yangwei251003/phyllotaxis/mechanical/BRIEF.md

# 参数化结构简报 · 历史设计过程

当前使用 [PROTO-02结构说明](prototype-v02/BRIEF.md)。下文保留旧电容高度等历史推导；最新总装为 `prototype-v02/assembly.step`。支持器件生成器默认使用PROTO-02，只有显式设置空版本变量才重放v01。

桌面光盘，水平放置；单位 mm，XY 为灯板平面，Z 向上，原点在底壳底面中心。尺寸见唯一来源 `../shared/design.json`。

设计由底壳、前框、2 mm 亚克力扩散片、PCB 包络和144个灯珠包络组成。外径200、底壳高42、壁厚3、底板厚3；180 mm PCB 底面安装高度30；四个M3通孔在85 mm半径上，与PCB共用坐标。

底壳预留通风槽、带护线圈的低压电源线入口和通用扎带固定孔。主控采用WeAct官方V3.1参考STEP；实际采购板与排针仍未核验。SEN0526麦克风支架及侧控件见下文controls-candidate-01。采购件3D模型技能在当前安装目录未找到，LED暂用供应商标称5×5×1.57包络，PCB为本设计外形包络。

前框以M3塑料自攻或经实测确认的螺钉装配；螺钉长度、孔收缩量、线缆护圈和模块固定点需最终器件实物核对。外壳不是已经验证的生产件。FDM初始建议PETG、0.2mm层高、4圈壁、20%填充；实际工艺由制造商确认。

DfAM修订：旧前框网格采样最薄0.505mm、p05=1mm，小于技能默认FDM支撑壁1.2mm，不能作为打印定稿。前框厚度由3改4mm，扩散片座底厚由1改2mm，前框螺钉中心半径由94改96mm，底壳对应柱半径由5改3.9mm以保持200mm外径。名义孔边到凹槽和外圆均留2.3mm；前框当前几何与concept-02一致。

器件净空修订：470uF候选电容数据表给出L=7.7mm、a=0.5mm，即以8.2mm作为最大总高包络。旧PCB顶面至扩散片仅8.4mm，剩0.2mm不够装配。因此底壳高由38改42mm，总装高46mm；PCB安装高度不变，正面空腔增为12.4mm，电容包络净空4.2mm。另计0.8mm装配/翘曲设计余量后仍余3.4mm，高于本项目自行设定的2mm目标。0.8mm不是厂家公差承诺。2026-10-03已将电容及其余支持器件实体摆放并检查，结果见12号文档，仍须实物验证。

THT接插件已置于PCB背面空腔，候选装配服务必须包含反面插件安装；当前位置和假定配插/线缆包络见08号文档，已做18组实体干涉检查。实际线材、插拔和焊脚尺寸仍须核验。

验收：每个主件为正体积闭合实体；外径和总高满足参数；孔与PCB同轴；LED与安装孔无碰撞；PCB与扩散片有正间隙；导出STEP/STL、实测渲染。量产公差、散热、电气安全和实际装配未验证。

## 可拆主控托架 · holder-candidate-01

这是新增零件与装配，不更改灯阵或外壳外径。托架原点位于自身底面中心，全局安装在底壳地板Z=3mm；PCB下表面座在全局Z=22mm，板的XY中心与底壳同心。WeAct原STEP原点在板角，上板面约Z=0、下板面约Z=-1.49144；通过命名座面与板中心下表面刚性配合，禁止目测拖动对齐。

托盘66×46mm、底厚3mm；长边两侧承托板外缘各0.6mm，不压住排针孔列。两根独立压条厚2.4mm，板厚设计包络1.8mm并另留0.3mm高度余量，限制抬起而不施加夹紧力。四个M3孔与2.6mm试验导孔同轴；导孔/螺钉需试配，尚未验证螺纹强度。两条尼龙扎带利用底壳既有孔，把托盘固定到底壳；底部脚垫需高于扎带厚度。

USB和SWD短边全开，板上三个键上方不设横梁。两侧排针下方各留51×3.6×15mm的假定线束空间，透明包络不是实物排针/插头模型，不能据此发布接线件采购规格。候选假设排针朝下、按本方案实际测试插线与弯曲半径。USB插拔留25×13×7mm服务空间；服务须移开灯板并断开外部5V，避免USB VBUS与外部供电并联。

路径：carrier.step.py、retainer.step.py（打印两件）、controller-assembly.step.py（官方板和托架）、controller-space.step.py（含假定空间）、service-assembly.step.py（拆灯板检查视图），均输出STEP。新打印件附STL/3MF。检验单实体、闭合正体积、包络、托架/板/压条相交体积、底壳接触、灯板净空、孔轴与扎带孔对齐、线束预留净距；生成并审查等轴与顶视图。实际板厚、针高、母头和线弯曲、打印收缩、固定强度未验证，不放行打印。

## 支持器件完整空间检查 · 2026-10-03

在保持灯阵、PCB、底壳和前框尺寸不变的前提下，把17个已布局SMD支持器件加入参数化装配。以当前原生PCB读回的器件位置/角度作为唯一位置来源；KiCad平面坐标(x,y)转换为机械坐标(x−100,100−y)，顶面器件使用同一逆时针旋转角。安装基面为PCB上表面Z=31.6mm，不根据预览手工拖动。

先检索step-parts：同routeId未找到可用匹配。已保存的LCSC库包含3D名称/UUID但不含STEP实体；针对电容和Q1的公开旧版STEP下载端点实测404。因此采用带来源和余量的封装包络，而不冒充厂商精确3D。每个包络由真实库器件body描线、原生焊盘外形和原厂最大外形矩形的凸包组成，再预留0.25mm平面余量；高度分别来自已核对图纸或明确工程预留。包络覆盖焊端、安装偏移的候选空间，不作为焊盘/电气模型。

主要新增输出为component-space.step.py/STEP，以及更新的assembly.step.py/STEP/GLB。17个包络分别验证闭合、正体积和安装基面；与底壳、前框、亚克力片、邻近LED、其他支持器件及背面连接器进行实体相交/最近距离核对。顶部还保留0.8mm装配/翘曲余量，净空目标2mm。最终板厚、元件公差及实际焊接仍需实物验证。原WeAct厂商STEP中已知的34项参考几何问题保留并单独报告；不能宣称总装所有厂商参考面已修复。

## 麦克风、按键和底脚 · controls-candidate-01

局部坐标X朝径向外、Y沿切线、Z向上。SEN0526支架在20°方位，板正面X=94、背面X=93、中心Z=18.5；2个Ø2安装孔位于Y=±6、Z=22。按二维孔位创建独立保守板及增大器件空间，不使用有缺陷的厂商模型作无碰撞证明。支架以底面Z=3落在壳地板，用2个M3通孔固定；上部两孔使用M1.6螺钉/螺母空间、2.2打印通孔与3.5AF螺母窝，避免要求打印1.3mm试验螺纹孔。针排在板背面朝壳内，支架下部留通道；需要商家按此方向预焊，具体接头/线弯尚未核验。侧壁Ø8声孔中心Z=19，用宽于参考声口偏移的开口避免按截图小孔坐标锁死声道；最终声学响应仍须测量。

两个GQ12H-10M-N按键位于160°/200°，中心Z=19。曲壁各融合22×22mm平面安装区，径向厚5mm（X95到100），通孔Ø12.4为候选打印余量；原厂图名义Ø12，收缩与最终装配须试配。头径13.9、突出2.9、后端19.5来自官方系列图；螺母Ø17×3及尾部12×9×9空间另标工程预留。拆下灯板后安装螺母、检查接线，不假定闭壳还能伸入扳手。

新增4个Ø12×5高的粘贴底脚空间，中心半径70，令M3底部头部与扎带离桌面。壳体本身仍高46mm，含未压缩底脚理论总高51mm；实际脚压缩和材料未核验。更新底壳、麦克风支架、控制装配/检修视图和总装STEP，打印件STL/3MF及DfAM检查；保留灯阵PCB和扩散片/前框不变。检查实体验证、孔轴/螺母窝关系、接触与穿透体积、声路及线束空间、基座连续性和新快照。
