yangwei251003/phyllotaxis/mechanical/prototype-v02/BRIEF.md

# PROTO-02 结构交付

单位mm；桌面水平摆放；外径200，总装高46，含5mm脚垫为51。完整STEP已重新读入，包络200×200×51，323个实体句柄；其中包含采购件参考模型，不是323个需要打印的零件。

本版只把灯板支持器件更新为八颗270µF电容。LED与板孔、连接器、壳体、前框、主控托架和麦克风支架没有变化。电容实体按6.1mm最大物理高度加0.4mm设计预留；21个支持器件空间检查无受测穿透，顶部净空5.9mm，扣0.8mm工程预留后5.1mm。

打印底壳base×1、前框bezel×1、主控托架carrier×1、压条retainer×2、麦克风支架microphone-holder×1，使用上层目录相应STL/3MF。材料PETG，参考切片208.82g；制造方须按实际设备重新切片并清除支撑，不使用另一台打印机的G-code。扩散片为Ø183.4×2mm亚克力，见`../diffuser.step`，另购四只Ø12×5mm脚垫。

采购件与紧固件、装配顺序见`../../docs/23-purchase-and-assembly.md`，电气连接与烧录见22号说明。主控需朝下排针版本，线束沿底部固定；拆灯板后才能维护USB和SWD端口。

`assembly.step.py`是最新入口。生成依赖本机CAD技能的cadgen与build123d、同目录高度/空间JSON、上层parts/controller/controls/connectors/components模块、shared数据及原厂参考STEP。现有独立STEP可直接在通用CAD软件打开，不依赖Python。

WeAct原厂参考模型有34项已记录几何问题，总装不称为全实体严格验证通过。打印件、孔配合、排针与线弯、负载与温升仍须实际安装验证；零件来源和未验证状态保留在资料中。
