yangwei251003/phyllotaxis/hardware/prototype-v02/PHYLLO-v02-schematic.pdf

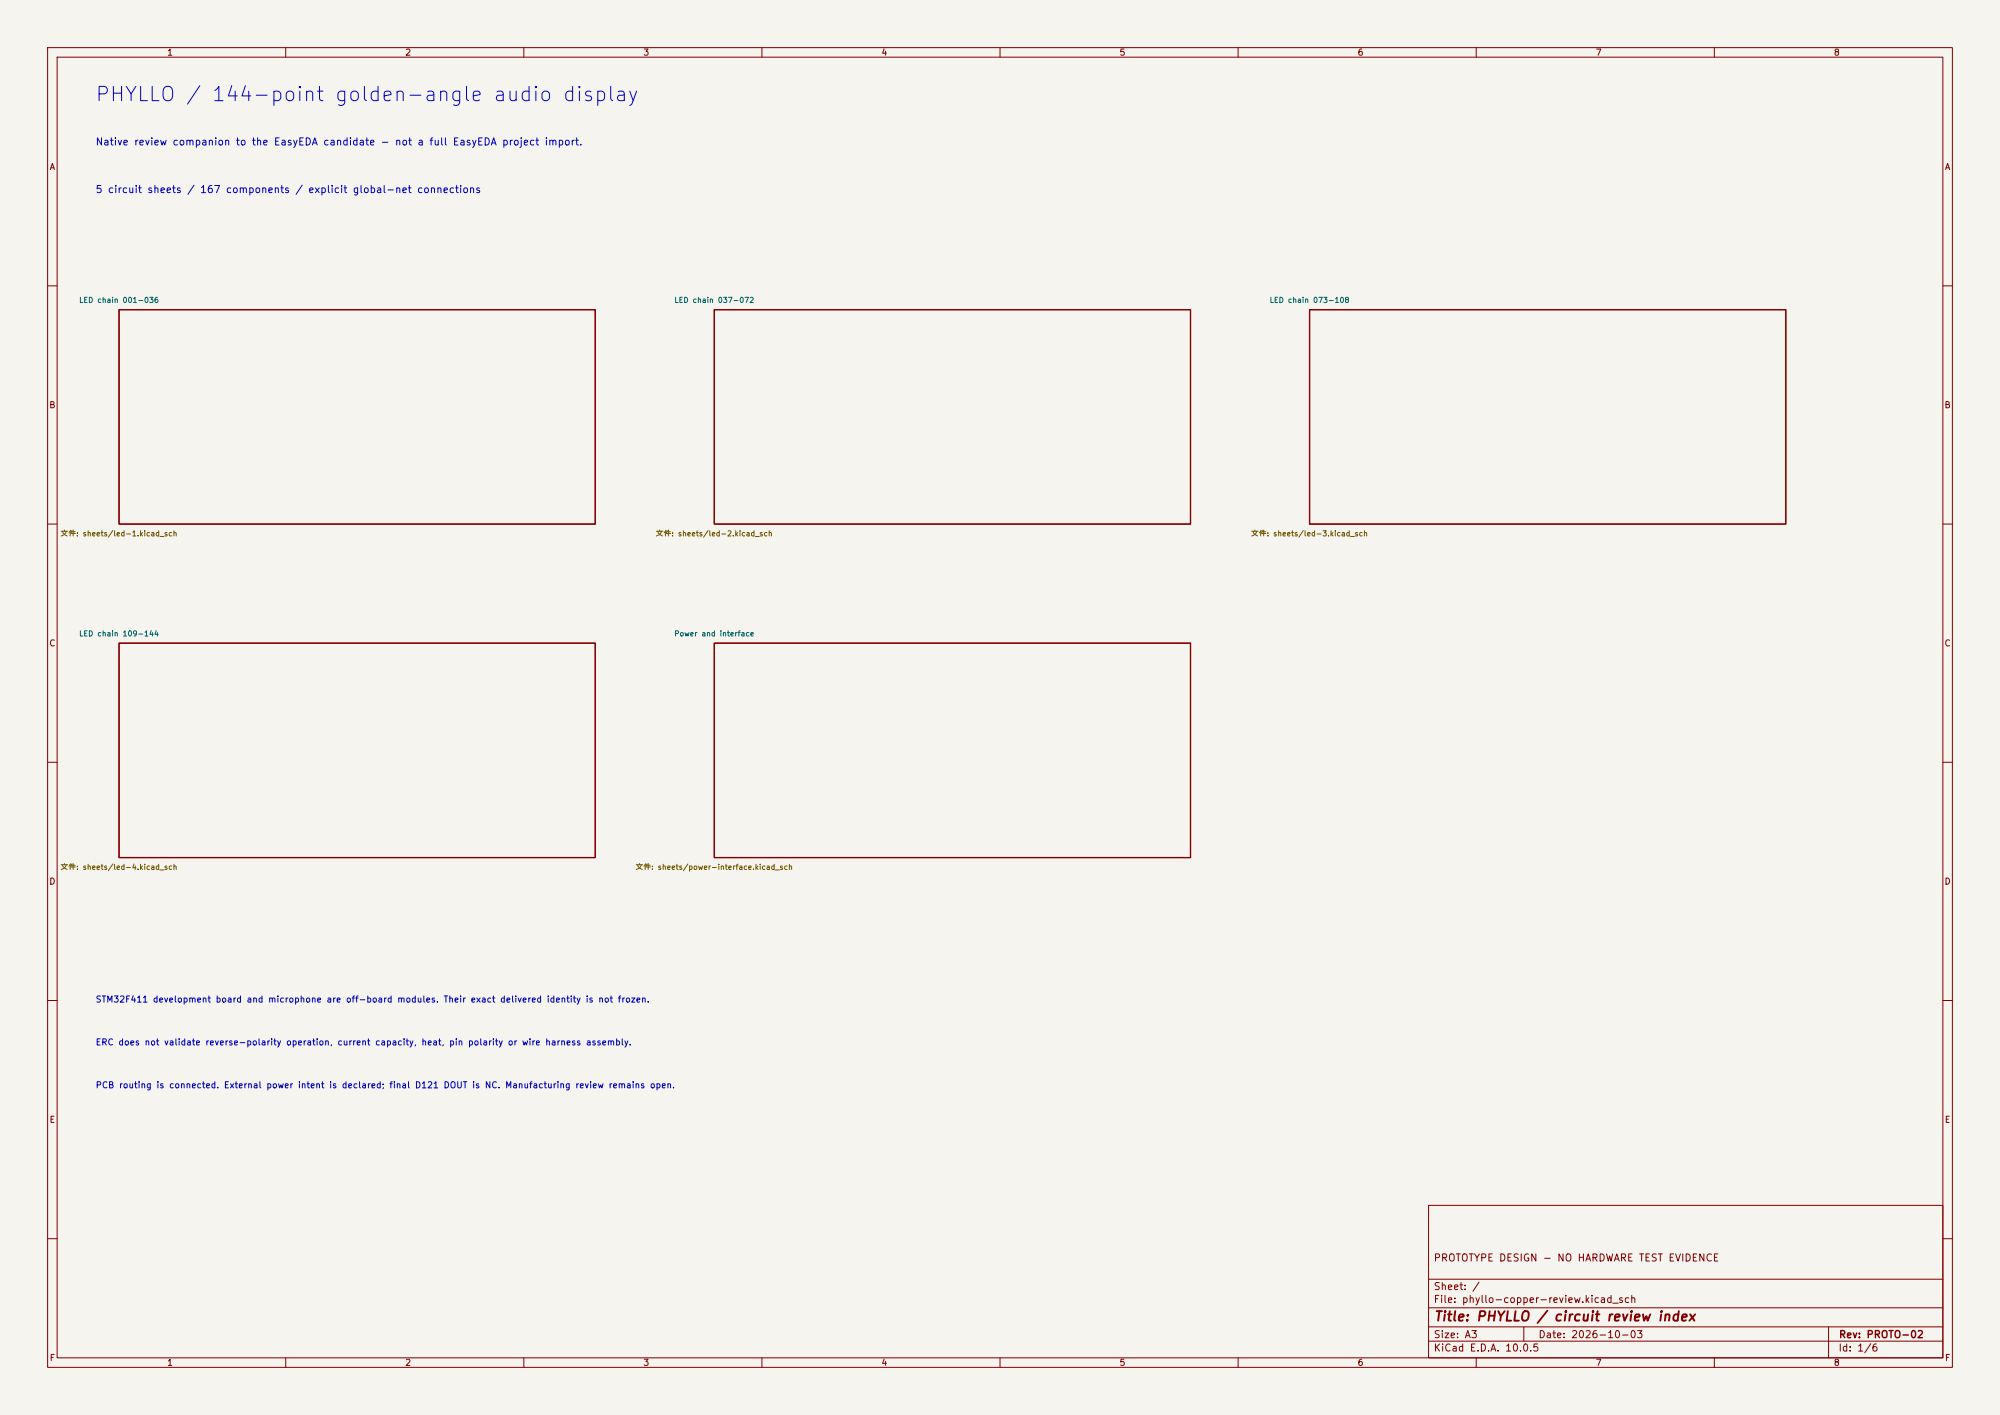
[picture p3: page 1]

STM32F411 development board and microphone are off-board modules. Their exact delivered identity is not frozen. ERC does not validate reverse-polarity operation, current capacity, heat, pin polarity or wire harness assembly. PCB routing is connected. External power intent is declared; final D121 DOUT is NC. Manufacturing review remains open. PHYLLO / 144-point golden-angle audio display
LED chain 001-036 文件: sheets/led-1.kicad_sch

Native review companion to the EasyEDA candidate - not a full EasyEDA project import.

5 circuit sheets / 167 components / explicit global-net connections

LED chain 073-108 文件: sheets/led-3.kicad_sch Power and interface 文件: sheets/power-interface.kicad_sch

LED chain 037-072 文件: sheets/led-2.kicad_sch

LED chain 109-144 文件: sheets/led-4.kicad_sch

PROTOTYPE DESIGN - NO HARDWARE TEST EVIDENCE

Sheet: /
File: phyllo-copper-review.kicad_sch
Title: PHYLLO / circuit review index

Size: A3 | Rev: PROTO-02 | F Date: 2026-10-03
KiCad E.D.A. 10.0.5 | Id: 1/6

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
# Title: LED chain 001-036

## File: led-1.kicad_sch

## Sheet: /LED chain 001-036/

## PROTOTYPE DESIGN - NO HARDWARE TEST EVIDENCE

VDD 1 | DOUT | 2
VSS | 3 DIN 4 | D94 WS2812B-B-V6
VDD 1 | DOUT | 2
VSS | 3 DIN 4 | D118 WS2812B-B-V6
VDD 1 | DOUT | 2
VSS | 3 DIN 4 | D89 WS2812B-B-V6
VDD 1 | DOUT | 2
VSS | 3 DIN 4 | D31 WS2812B-B-V6

VDD

1 | DOUT | 2
| VSS

3 DIN

4 | D144 WS2812B-B-V6
VDD 1 | DOUT | 2
VSS | 3 DIN 4 | D73 WS2812B-B-V6
VDD 1 | DOUT | 2
VSS | 3 DIN 4 | D126 WS2812B-B-V6
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

GND

DATA_109

5V_LED

5V_LED

DATA_114 | DATA_115 GND

DATA_115

5V_LED

GND

DATA_110 | DATA_110
| 5V_LED

DATA_116

5V_LED

DATA_116 Pin numbers/names from saved vendor library. Global labels join all sheets. No fabrication release. PHYLLO / LED chain 109-144 / candidate pin-table schematic

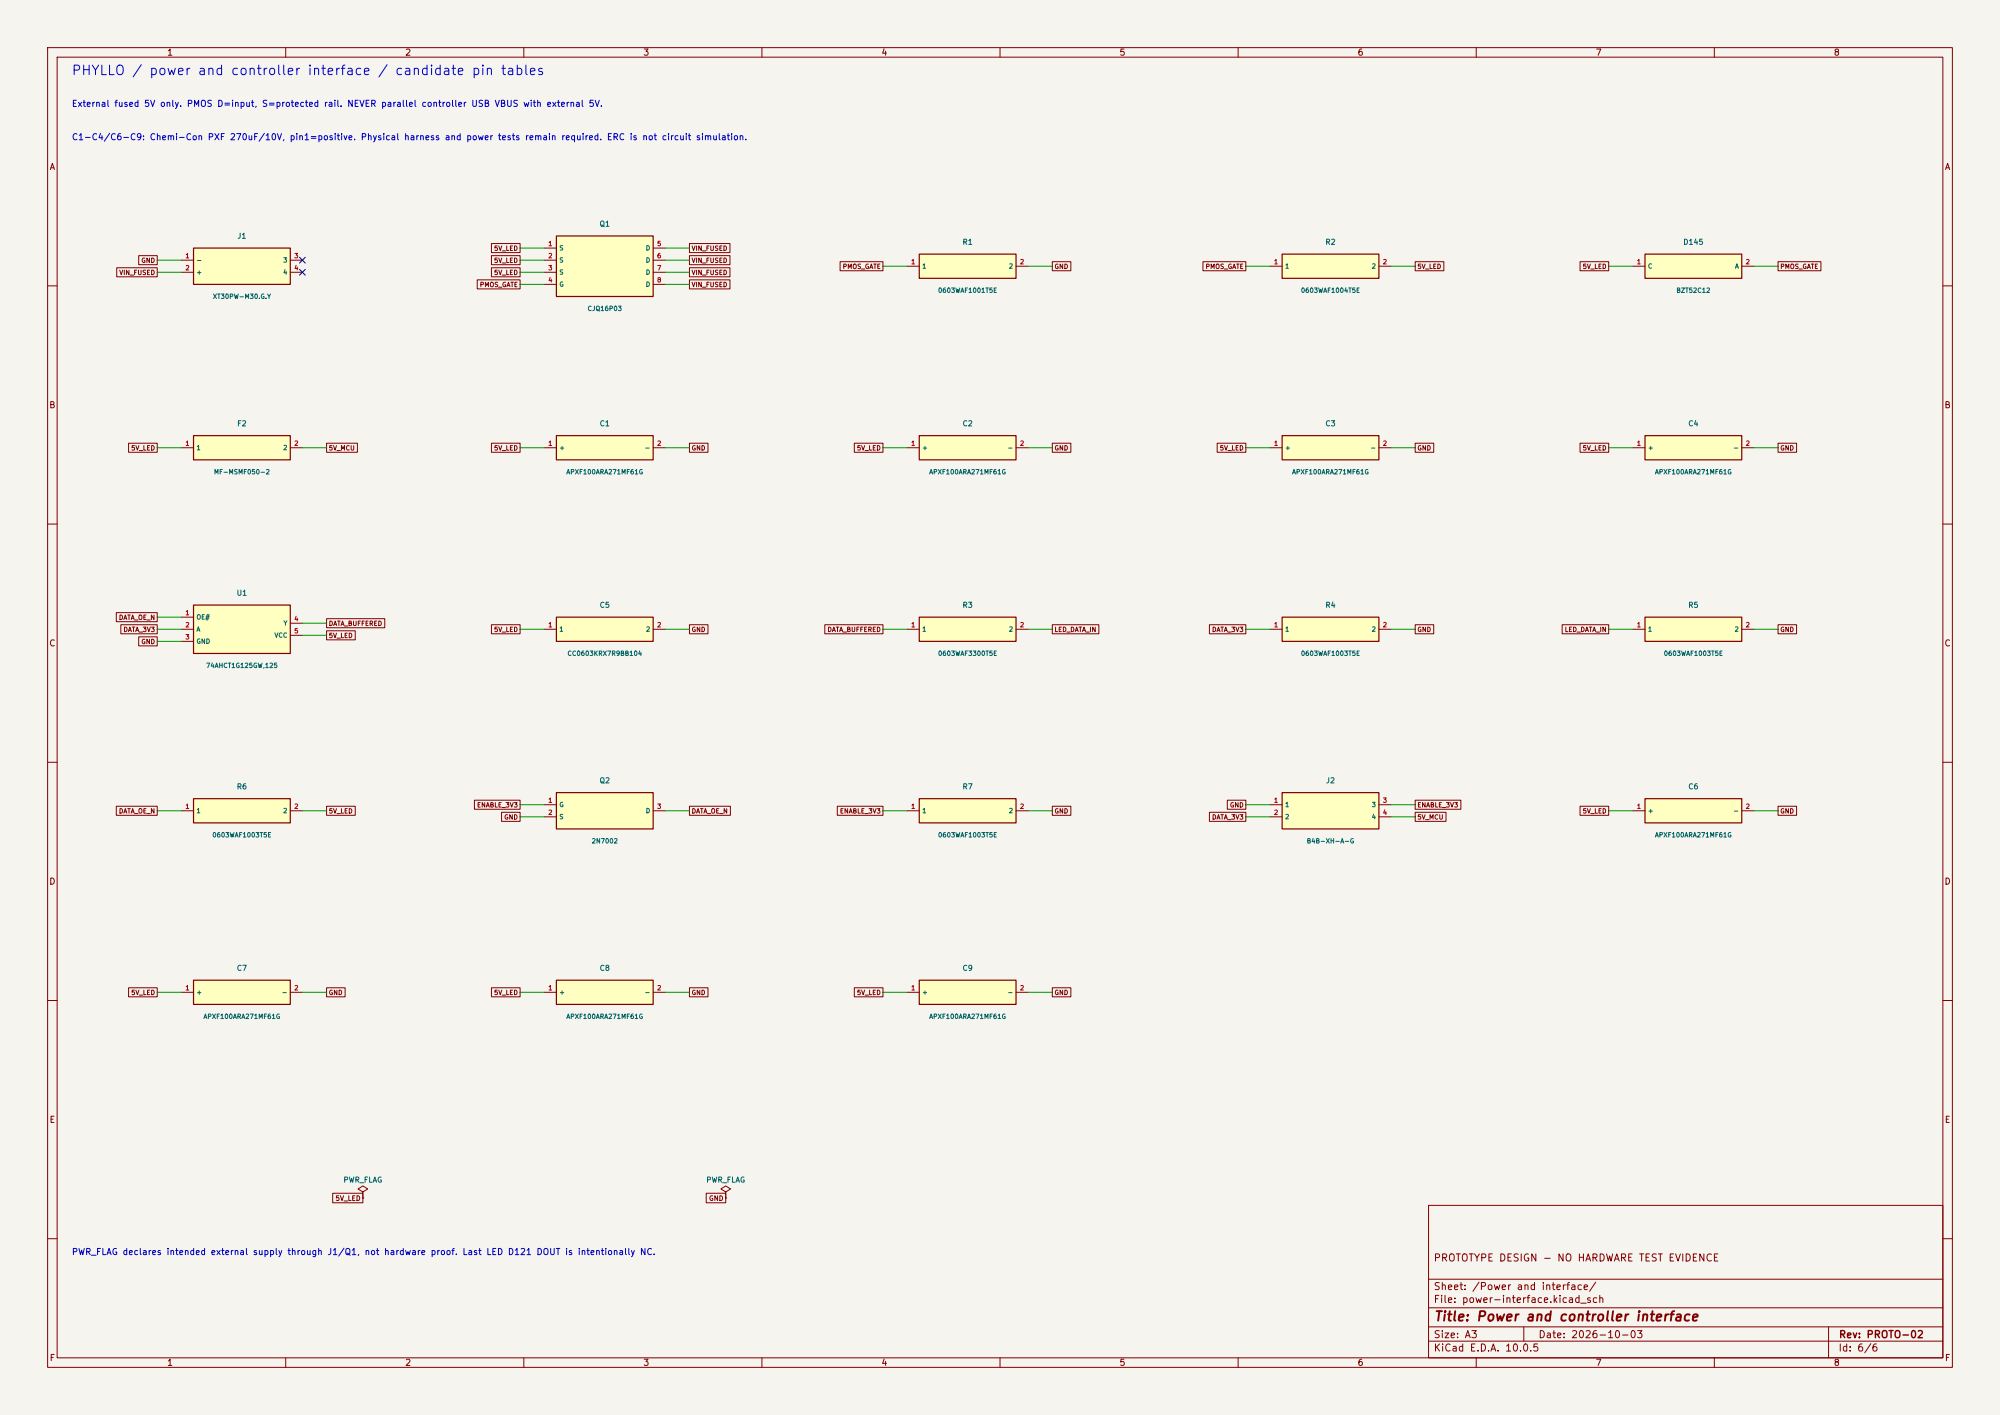
[picture p4: page 6]

C1-C4/C6-C9: Chemi-Con PXF 270uF/10V, pin1=positive. Physical harness and power tests remain required. ERC is not circuit simulation. External fused 5V only. PMOS D=input, S=protected rail. NEVER parallel controller USB VBUS with external 5V. PHYLLO / power and controller interface / candidate pin tables

PWR_FLAG declares intended external supply through J1/Q1, not hardware proof. Last LED D121 DOUT is intentionally NC.

PROTOTYPE DESIGN - NO HARDWARE TEST EVIDENCE

Sheet: /Power and interface/
File: power-interface.kicad_sch
Title: Power and controller interface
