yangwei251003/phyllotaxis/PROVENANCE.md

# 来源与公开范围

由维护者PHYLLO本地工程整理，保留原有应用、C核心、板级固件源、共享几何、电路源、机械生成代码与独立自有零件导出。配图来自原项目保存的真实网页和候选模型渲染，不冒充实物。

公开副本对本机绝对路径做了泛化；固件日志/编译收据改放被忽略的运行目录。除本地网页服务增加可选择临时端口外，没有在本次整理推进硬件新设计或修改控制算法。

## 未公开的内容

- 第三方SDK缓存、工具安装包、生成缓存、构建目录和二进制。
- 个人预算、采购/询价、报价截图、状态账本、事件与私人交付包。
- 重新分发许可尚未确认的厂商参考CAD、原始器件库、数据手册，以及包含厂商参考实体的完整装配STEP/GLB。
- 包含私有采购说明的历史打印交付打包脚本。

原生EDA设计文件及自有审阅符号/封装保留工程来源；并不通过本项目MIT重新授权厂商软件、数据或元器件参考模型。历史源说明可能提及未随公开版收录的资料，不能据这些引用认定资料已上传。

由于上述排除与开发中状态，本仓库不能作为“原本地文件夹全部可删除”的依据。
