yangwei251003/phyllotaxis/hardware/prototype-v02/readable-circuit/circuit-1.png

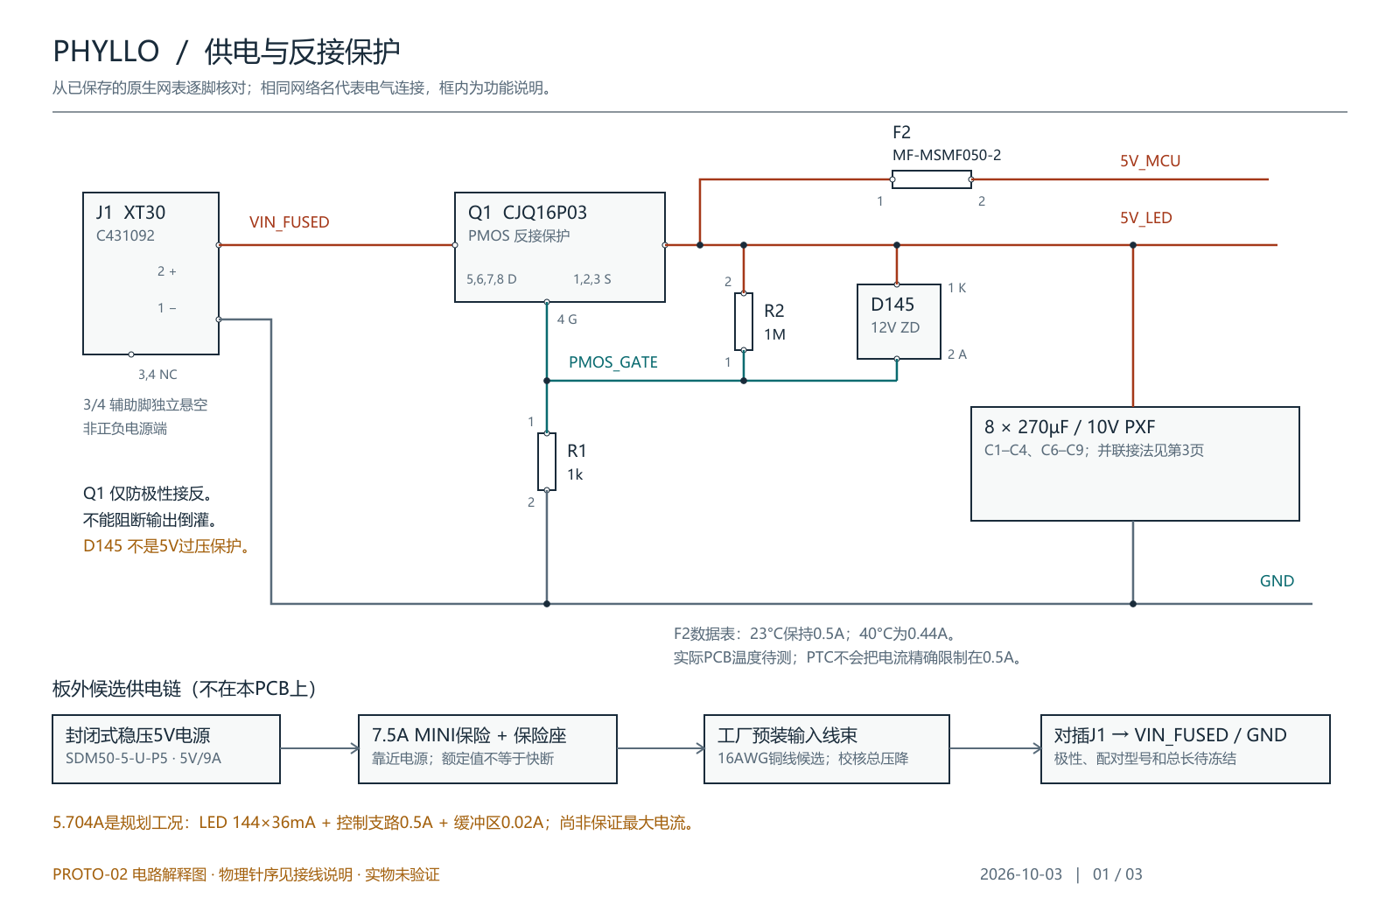
hardware/prototype-v02/readable-circuit/circuit-1.png
