yangwei251003/phyllotaxis/hardware/prototype-v02/readable-circuit/circuit-3.png

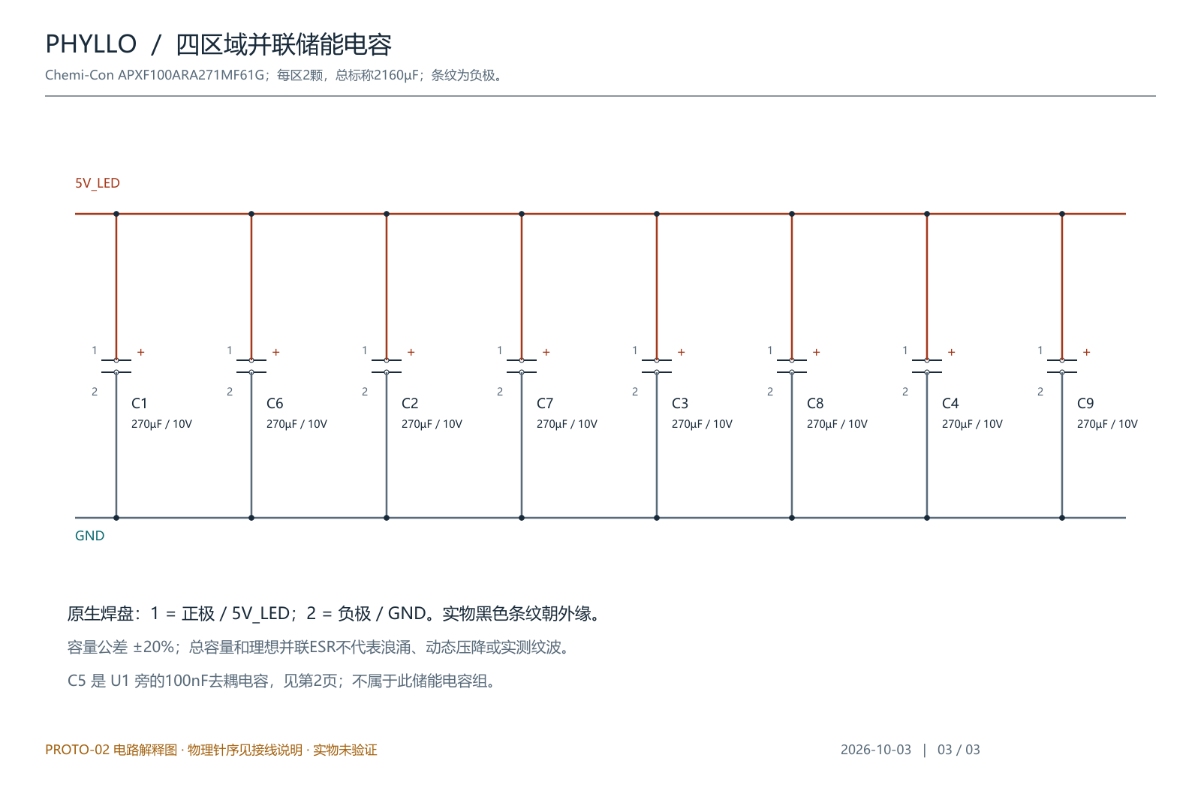
hardware/prototype-v02/readable-circuit/circuit-3.png
