yangwei251003/phyllotaxis/hardware/manufacturing-output-REVIEW/README-NOT-FOR-ORDER.txt

PHYLLO LOCAL MANUFACTURING REVIEW ONLY. DO NOT ORDER OR FABRICATE FROM THIS DIRECTORY.
Board SHA256: 17f93c409632b65271121363c62a9ff14ae228ac94b24b676f731eafd3b3479e
Coordinate origin: KiCad absolute; native positions use Y-up and native angle conventions. Vendor BOM/CPL mapping and placement preview are not approved.
Pending: full assembly geometry, actual parts/harness, capacitor polarity/rotation confirmation, factory stackup/quote and final release review.
