yangwei251003/phyllotaxis/hardware/eda/candidate-bom-NOT-FOR-ORDER.csv

Status | Designator | Quantity | Manufacturer | Manufacturer Part | Footprint | LCSC Part | Assembly class from library
DRAFT / no PCB parity | U1 | 1 | Nexperia(安世) | 74AHCT1G125GW,125 | SOT-353 | C12495 | Extended Part
DRAFT / no PCB parity | C5 | 1 | YAGEO(国巨) | CC0603KRX7R9BB104 | 0603 | C14663 | Basic Part
DRAFT / no PCB parity | F2 | 1 | BOURNS | MF-MSMF050-2 | 1812 | C17313 | Extended Part
DRAFT / no PCB parity | R1 | 1 | UNI-ROYAL(厚声) | 0603WAF1001T5E | 0603 | C21190 | Basic Part
DRAFT / no PCB parity | R2 | 1 | UNI-ROYAL(厚声) | 0603WAF1004T5E | 0603 | C22935 | Basic Part
DRAFT / no PCB parity | R3 | 1 | UNI-ROYAL(厚声) | 0603WAF3300T5E | 0603 | C23138 | Basic Part
DRAFT / no PCB parity | R4,R5,R6,R7 | 4 | UNI-ROYAL(厚声) | 0603WAF1003T5E | 0603 | C25803 | Basic Part
DRAFT / no PCB parity | D145 | 1 | BORN(伯恩半导体) | BZT52C12 | SOD-123 | C271259 | Extended Part
DRAFT / no PCB parity | Q1 | 1 | CJ(江苏长电/长晶) | CJQ16P03 | SOP-8 | C2910138 | Extended Part
DRAFT / no PCB parity | J1 | 1 | AMASS(艾迈斯) | XT30PW-M30.G.Y | - | C431092 | Extended Part
DRAFT / no PCB parity | C1,C2,C3,C4 | 4 | JIERR(捷而瑞) | MA10V470M6X8 | SMD,D6.3xL7.7mm | C46550459 | Extended Part
DRAFT / no PCB parity | D1,D2,D3,D4,D5,D6,D7,D8,D9,D10,D11,D12,D13,D14,D15,D16,D17,D18,D19,D20,D21,D22,D23,D24,D25,D26,D27,D28,D29,D30,D31,D32,D33,D34,D35,D36,D37,D38,D39,D40,D41,D42,D43,D44,D45,D46,D47,D48,D49,D50,D51,D52,D53,D54,D55,D56,D57,D58,D59,D60,D61,D62,D63,D64,D65,D66,D67,D68,D69,D70,D71,D72,D73,D74,D75,D76,D77,D78,D79,D80,D81,D82,D83,D84,D85,D86,D87,D88,D89,D90,D91,D92,D93,D94,D95,D96,D97,D98,D99,D100,D101,D102,D103,D104,D105,D106,D107,D108,D109,D110,D111,D112,D113,D114,D115,D116,D117,D118,D119,D120,D121,D122,D123,D124,D125,D126,D127,D128,D129,D130,D131,D132,D133,D134,D135,D136,D137,D138,D139,D140,D141,D142,D143,D144 | 144 | worldsemi | WS2812B-B-V6 | SMD5050-4P | C52941391 | Extended Part
DRAFT / no PCB parity | J2 | 1 | JST | B4B-XH-A-G | 插件,P=2.5mm | C594232 | Extended Part
DRAFT / no PCB parity | Q2 | 1 | CJ(江苏长电/长晶) | 2N7002 | SOT-23 | C8545 | Basic Part
