yangwei251003/phyllotaxis/mechanical/controls-assembly.step

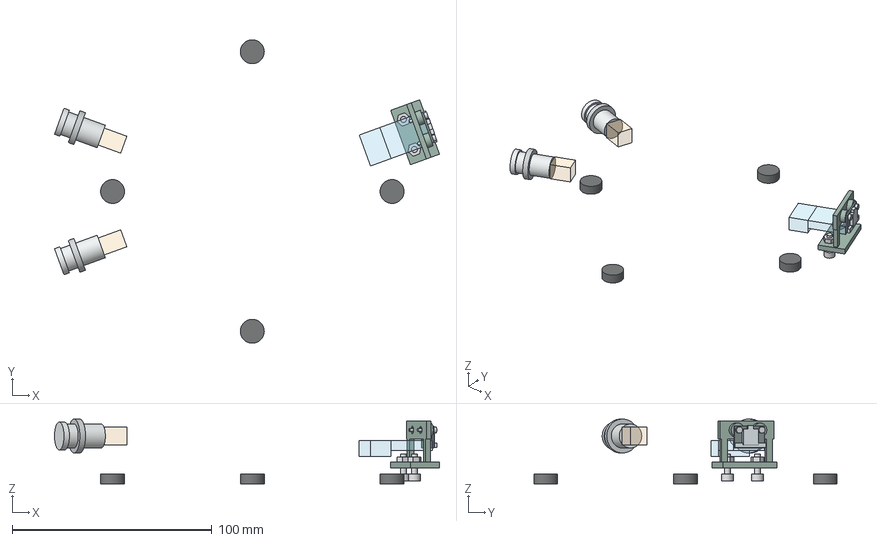
[picture p8: CAD file, 2026-10-26]
mechanical/controls-assembly.step
192.8 x 152.0 x 32.5 mm
Microphone_holder_PETG_M1p6_nut_pockets_and_M3_base
SEN0526_board_hole_datum_ENVELOPE_not_vendor_model
SEN0526_components_MAX_plus_RESERVE
M1p6x8_head_ENVELOPE_-1
M1p6_nut_ENVELOPE_-1
M1p6x8_head_ENVELOPE_+1
M1p6_nut_ENVELOPE_+1
M3x10_floor_screw_ENVELOPE_1
M3_floor_nut_ENVELOPE_1
M3x10_floor_screw_ENVELOPE_2
M3_floor_nut_ENVELOPE_2
ASSUMED_SEN0526_back_header_plug_space
ASSUMED_SEN0526_wire_bend_space
GQ12H10M_N_body_and_terminals_ENVELOPE_1
GQ12_nut_RESERVE_not_exact_nut_1
ASSUMED_button_pre_wired_bend_space_1
GQ12H10M_N_body_and_terminals_ENVELOPE_2
GQ12_nut_RESERVE_not_exact_nut_2
ASSUMED_button_pre_wired_bend_space_2
Adhesive_rubber_foot_ENVELOPE_1
Adhesive_rubber_foot_ENVELOPE_2
Adhesive_rubber_foot_ENVELOPE_3
Adhesive_rubber_foot_ENVELOPE_4
