yangwei251003/phyllotaxis/mechanical/connector-space.step

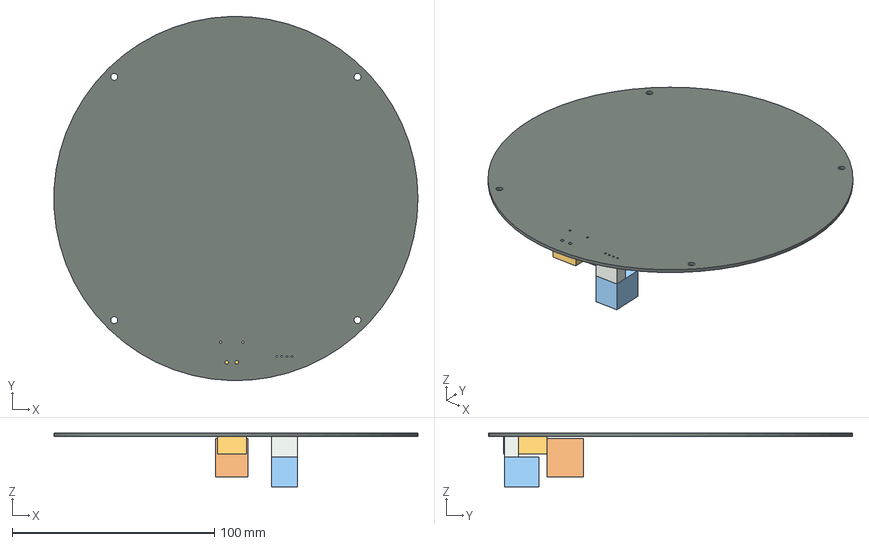
[picture p9: CAD file, 2026-10-26]
mechanical/connector-space.step
179.9 x 179.9 x 26.6 mm
PCB_ENVELOPE_not_routed
XT30_MATED_ENVELOPE_candidate
JST_XH_MATED_ENVELOPE_candidate
XT30_WIRE_BEND_ASSUMED
JST_WIRE_BEND_ASSUMED
