yangwei251003/phyllotaxis/mechanical/microphone-holder.step

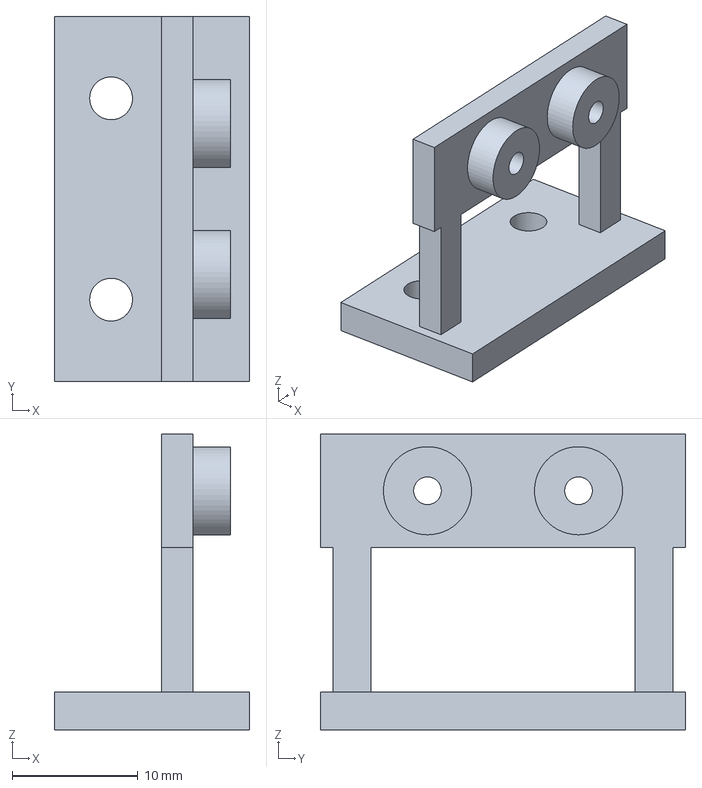
[picture p10: CAD file, 2026-10-26]
mechanical/microphone-holder.step
15.5 x 29.0 x 23.5 mm
