yangwei251003/phyllotaxis/mechanical/diffuser.step

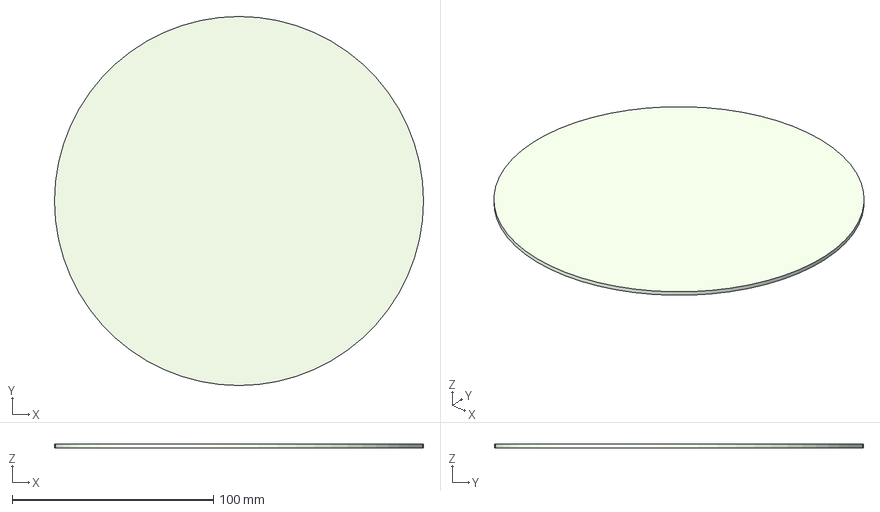
[picture p11: CAD file, 2026-10-26]
mechanical/diffuser.step
183.4 x 183.4 x 2.00 mm
