yangwei251003/phyllotaxis/mechanical/bezel.step

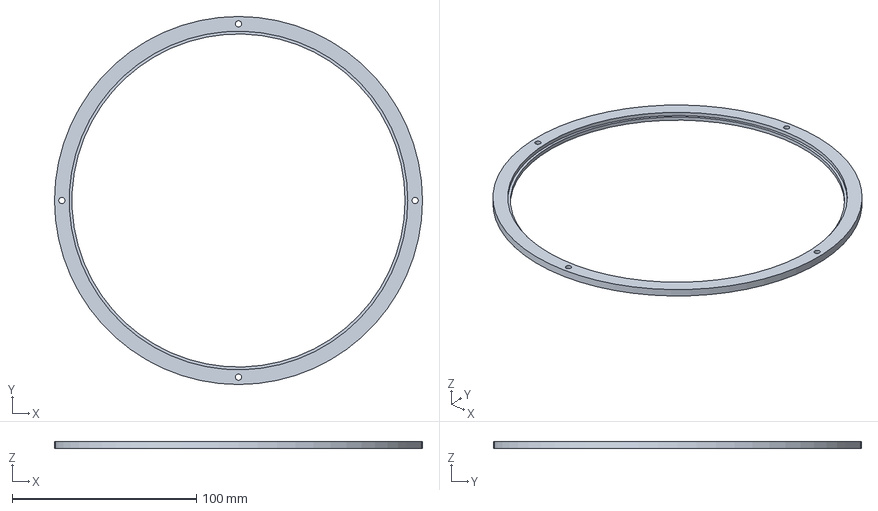
[picture p12: CAD file, 2026-10-26]
mechanical/bezel.step
200.0 x 200.0 x 4.00 mm
