yangwei251003/phyllotaxis/mechanical/carrier.step

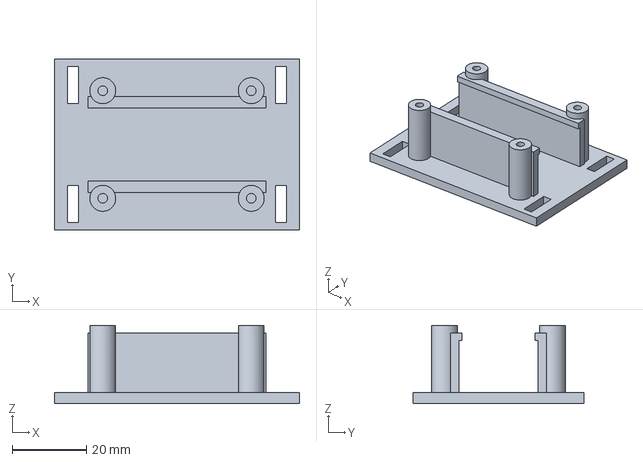
[picture p13: CAD file, 2026-10-26]
mechanical/carrier.step
66.0 x 46.0 x 21.1 mm
