yangwei251003/phyllotaxis/mechanical/base.step

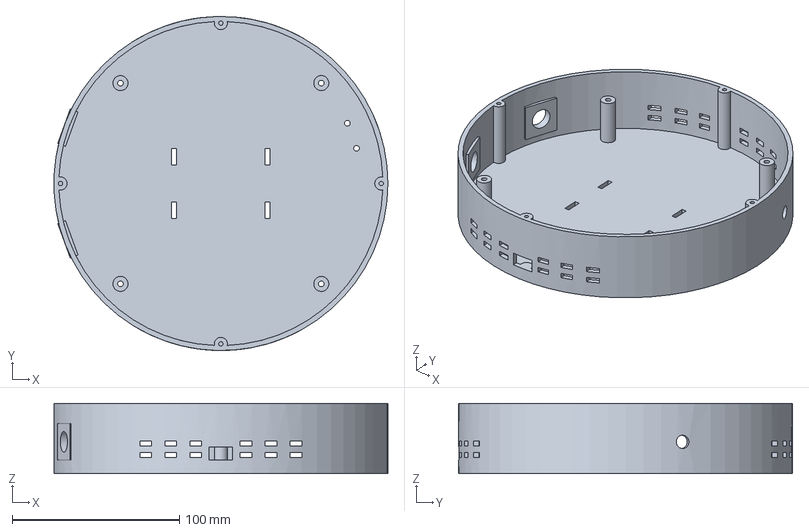
[picture p14: CAD file, 2026-10-26]
mechanical/base.step
199.9 x 199.9 x 42.0 mm
