yangwei251003/phyllotaxis/mechanical/component-space.step

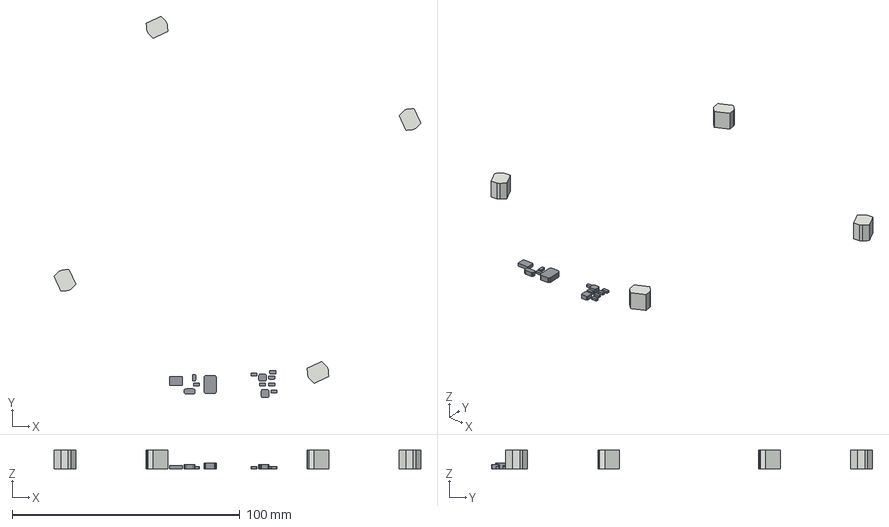
[picture p15: CAD file, 2026-10-26]
mechanical/component-space.step
161.0 x 167.2 x 8.20 mm
SPACE_Q1_C2910138_CONSERVATIVE_NOT_VENDOR_MODEL
SPACE_R7_C25803_CONSERVATIVE_NOT_VENDOR_MODEL
SPACE_D145_C271259_CONSERVATIVE_NOT_VENDOR_MODEL
SPACE_R3_C23138_CONSERVATIVE_NOT_VENDOR_MODEL
SPACE_U1_C12495_CONSERVATIVE_NOT_VENDOR_MODEL
SPACE_C1_C46550459_CONSERVATIVE_NOT_VENDOR_MODEL
SPACE_C3_C46550459_CONSERVATIVE_NOT_VENDOR_MODEL
SPACE_R1_C21190_CONSERVATIVE_NOT_VENDOR_MODEL
SPACE_C2_C46550459_CONSERVATIVE_NOT_VENDOR_MODEL
SPACE_R2_C22935_CONSERVATIVE_NOT_VENDOR_MODEL
SPACE_Q2_C8545_CONSERVATIVE_NOT_VENDOR_MODEL
SPACE_R5_C25803_CONSERVATIVE_NOT_VENDOR_MODEL
SPACE_F2_C17313_CONSERVATIVE_NOT_VENDOR_MODEL
SPACE_R6_C25803_CONSERVATIVE_NOT_VENDOR_MODEL
SPACE_C5_C14663_CONSERVATIVE_NOT_VENDOR_MODEL
SPACE_C4_C46550459_CONSERVATIVE_NOT_VENDOR_MODEL
SPACE_R4_C25803_CONSERVATIVE_NOT_VENDOR_MODEL
