yangwei251003/phyllotaxis/mechanical/retainer.step

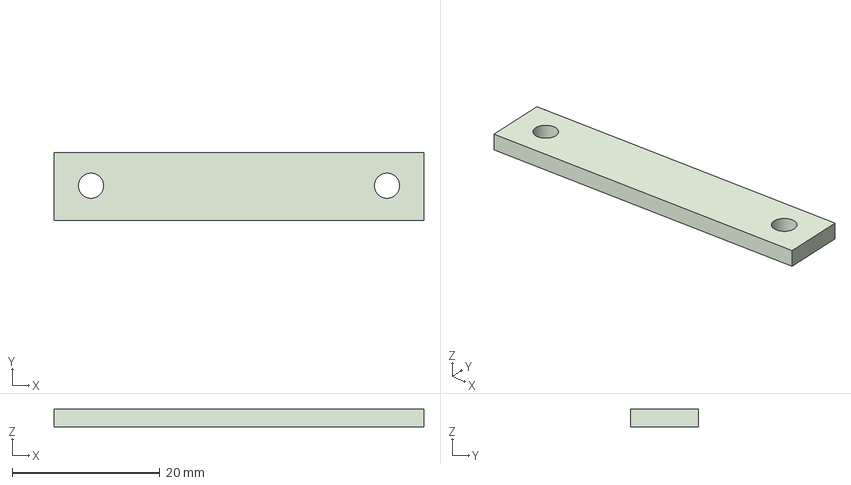
[picture p16: CAD file, 2026-10-26]
mechanical/retainer.step
50.0 x 9.21 x 2.40 mm
