yangwei251003/phyllotaxis/(list of files, cad)

Other CAD files:
mechanical/base.3mf
mechanical/base.stl
mechanical/bezel.3mf
mechanical/bezel.stl
mechanical/carrier.3mf
mechanical/carrier.stl
mechanical/diffuser.3mf
mechanical/diffuser.stl
mechanical/microphone-holder.3mf
mechanical/microphone-holder.stl
mechanical/retainer.3mf
mechanical/retainer.stl
