yangwei251003/phyllotaxis/hardware/prototype-v02/manufacturing/front-paste.png

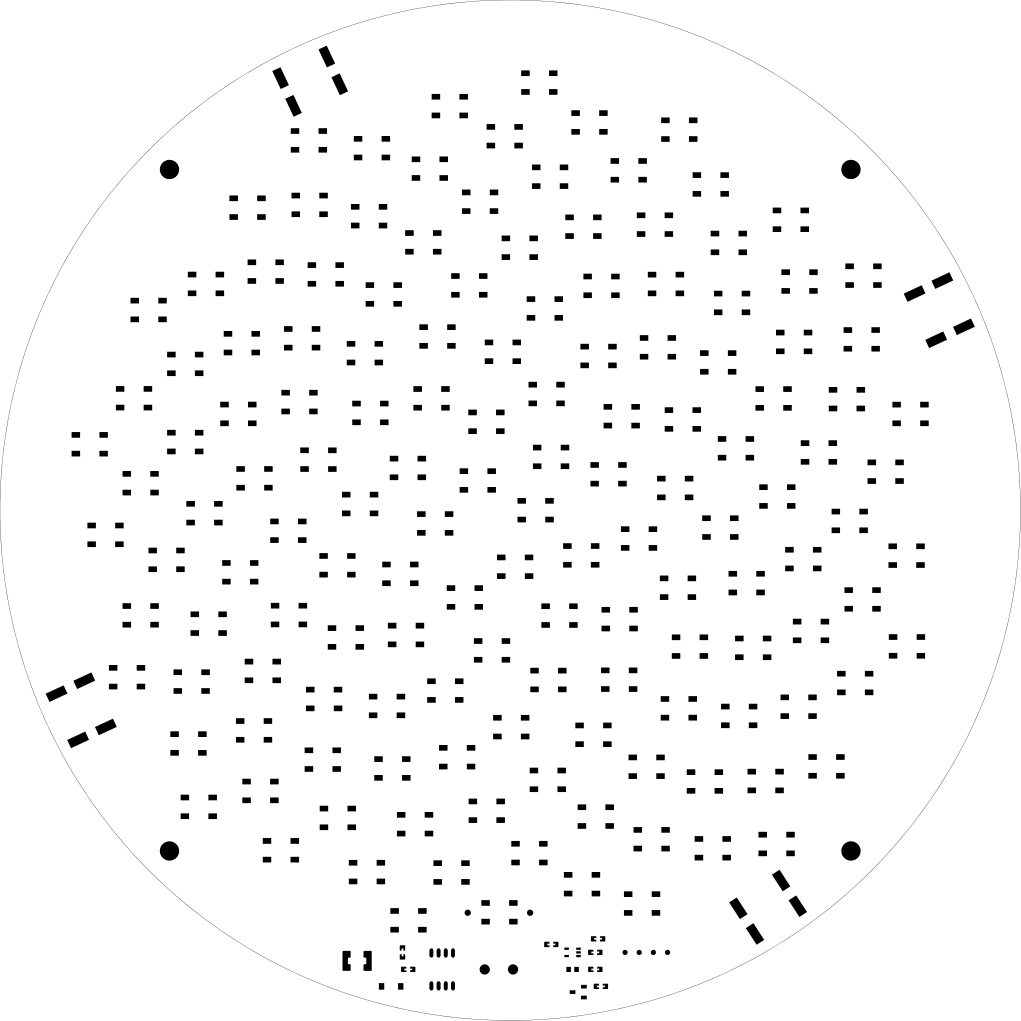
hardware/prototype-v02/manufacturing/front-paste.png
