yangwei251003/phyllotaxis/VALIDATION.md

# 本次公开副本验证

日期：2026-10-26。源工程、原活动服务和实物未修改。

- 网页已有单元测试：14/14通过，包含黄金角几何、音频基础、灯帧亮度/电流约束、共享坐标一致性和遥测状态边界。
- GCC/CMake主机核心：编译成功，1/1 CTest通过。
- ST依赖：在公开副本独立获取两个官方锁定仓库与6个CMSIS核心文件，提交/哈希验证通过；不直接随仓库公开。
- F411候选：离线配置、clean build和ELF/向量/地址范围/BIN一致性/未解析符号检查返回 `[0,0,0]`，0警告。
- 本地HTTP冒烟：仅启动自己的临时端口服务，8个静态资源返回200；随后结束该服务。
- README配图已人工查看，分别为原项目保存的真实网页设备区和候选结构渲染，没有实板照片或真实运行数据。

本次未启动EDA/Bridge、未复跑电路DRC/ERC、未推进新设计、未制造、未烧录、未采集硬件数据。历史报告与数字设计不得作为实板功能或生产放行证明。

后续GitHub Pages部署与在线浏览器验证由发布阶段单独记录；当前本地检查不冒充远端已部署。
