yangwei251003/phyllotaxis/CHANGELOG.md

# 更新日志

## 0.1.0 — 2026-10-26

- 整理现有PHYLLO网页、固件、几何、电路与自有零件资产，过滤个人信息、采购内容和缓存依赖。
- 供应商源码保持锁定获取，不将其整体改为MIT或捆绑发布。
- 运行日志和构建收据移到忽略目录；网页服务支持临时端口便于隔离验证。
- 增加可复现运行说明、真实原项目配图、验证边界与GitHub Pages工作流。

## 后续规划

- 在确认实际硬件身份后逐项接线、烧录和实测。
- 核实时序、采样、功耗、温升、线束和打印配合；当前不填写未发生的实验结果。
- 在原理图/PCB和制造审查闭环后再讨论生产放行。
