yangwei251003/phyllotaxis/hardware/prototype-v02/readable-circuit/PHYLLO-power-and-data-REVIEW.pdf

# PHYLLO / 供电与反接保护

从已保存的原生网表逐脚核对；相同网络名代表电气连接，框内为功能说明。

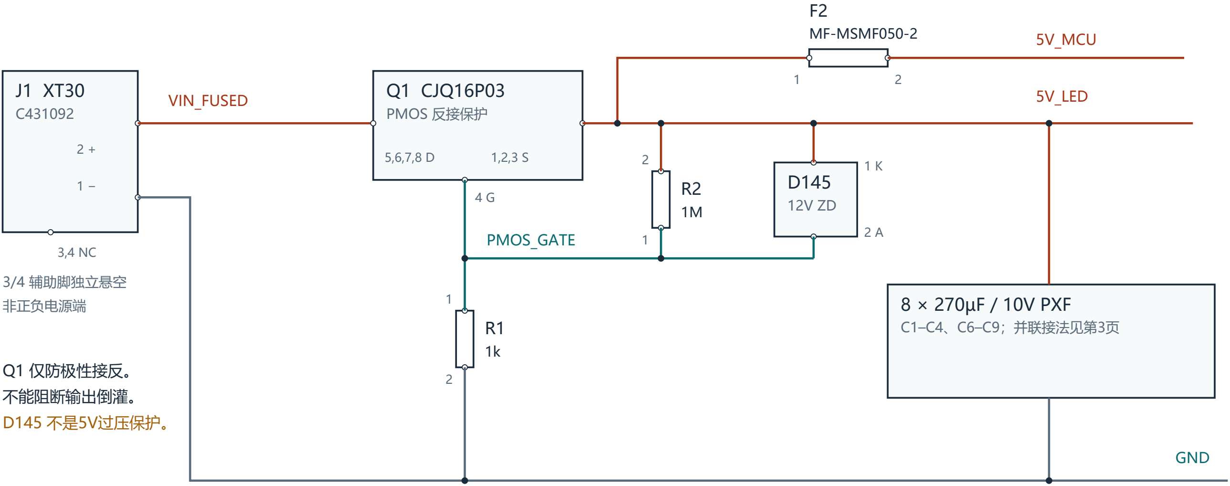
[picture p18: figure]
3/4 辅助脚独立悬空 非正负电源端; VIN_FUSED; Q1 CJQ16P03; PMOS 反接保护; 5V_LED; PMOS_GATE; GND; 8 × 270µF / 10V PXF C1–C4、C6–C9；并联接法见第3页; F2 MF-MSMF050-2; 5V_MCU; Q1 仅防极性接反。 不能阻断输出倒灌。 D145 不是5V过压保护。

PROTO-02 电路解释图 ∙ 物理针序见接线说明 ∙ 实物未验证 | 2026-10-03 | 01 / 03

F2数据表：23°C保持0.5A；40°C为0.44A。 实际PCB温度待测；PTC不会把电流精确限制在0.5A。

### 板外候选供电链（不在本PCB上）

### 封闭式稳压5V电源

SDM50-5-U-P5 ∙ 5V/9A

### 7.5A MINI保险 + 保险座

靠近电源；额定值不等于快断

### 工厂预装输入线束

16AWG铜线候选；校核总压降

### 对插J1 → VIN_FUSED / GND

极性、配对型号和总长待冻结

5.704A是规划工况：LED 144×36mA + 控制支路0.5A + 缓冲区0.02A；尚非保证最大电流。

# PHYLLO / 电平转换与上电隔离

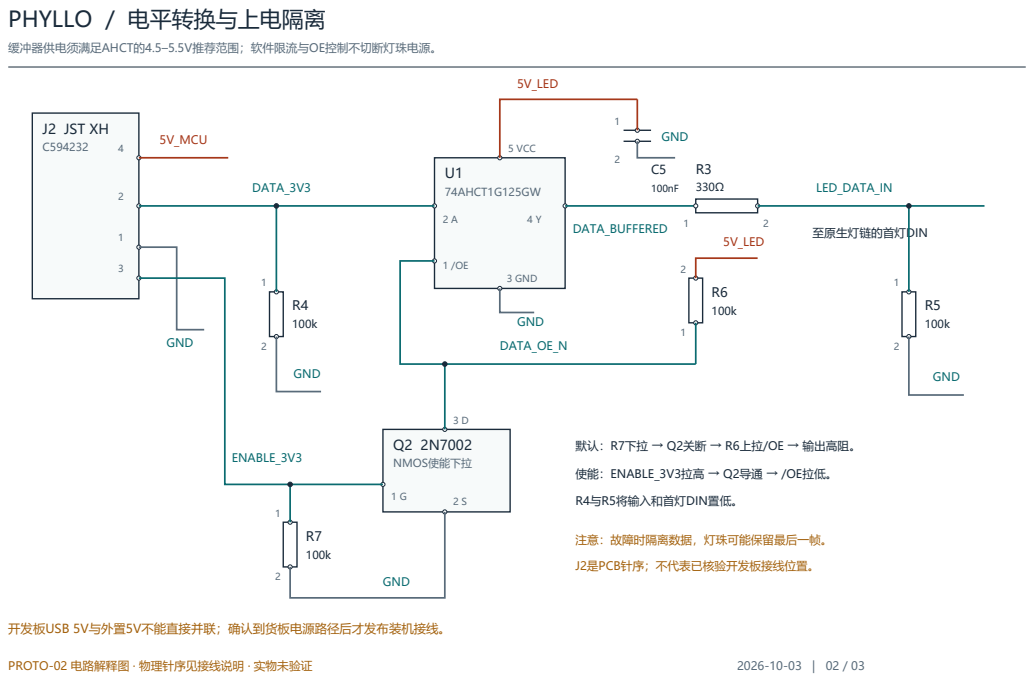
[picture p19: page 2]

# PHYLLO / 四区域并联储能电容

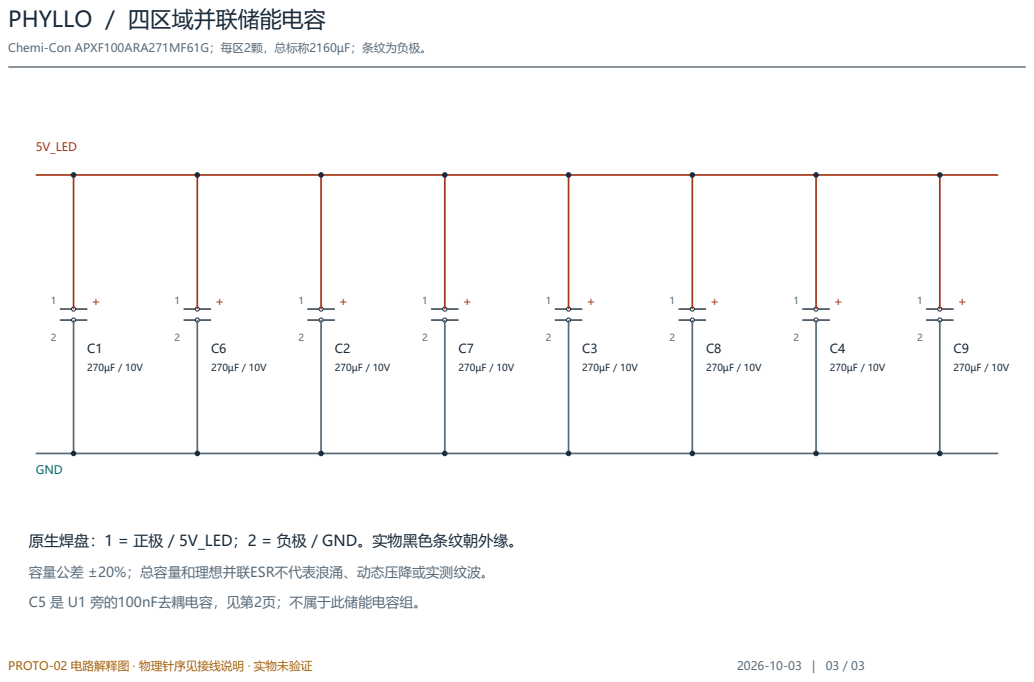
[picture p20: page 3]

原生焊盘：1 = 正极 / 5V_LED；2 = 负极 / GND。实物黑色条纹朝外缘。
容量公差 ±20%；总容量和理想并联ESR不代表浪涌、动态压降或实测纹波。
C5 是 U1 旁的100nF去耦电容，见第2页；不属于此储能电容组。
