yangwei251003/phyllotaxis/hardware/readable-circuit/PHYLLO-power-and-data-REVIEW.pdf

# PHYLLO / 供电与反接保护

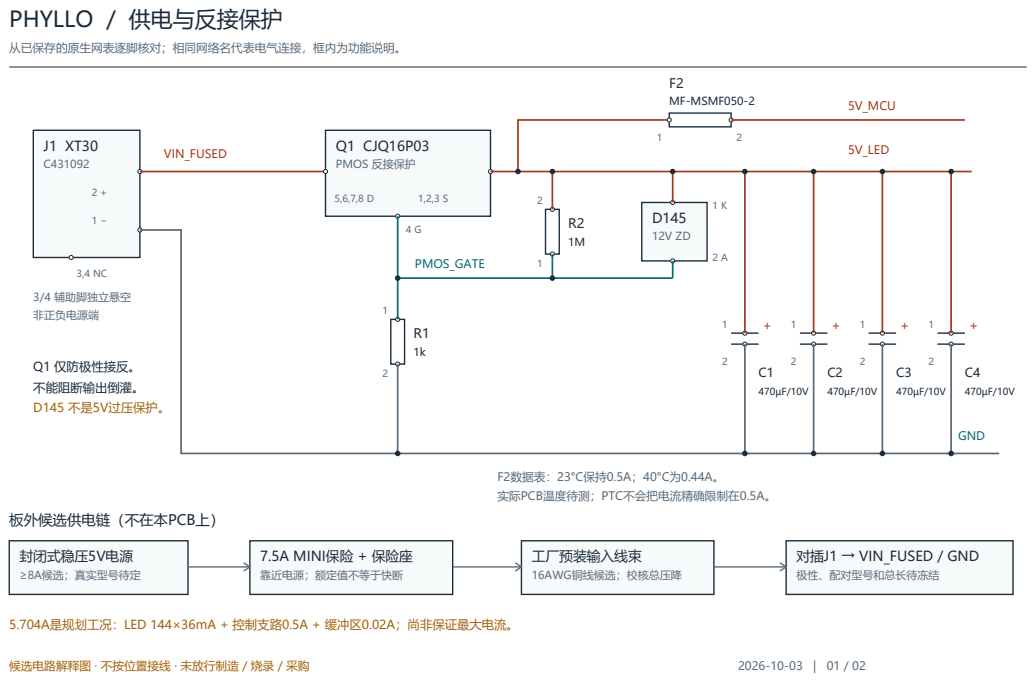
[picture p21: page 1]

# PHYLLO / 电平转换与上电隔离

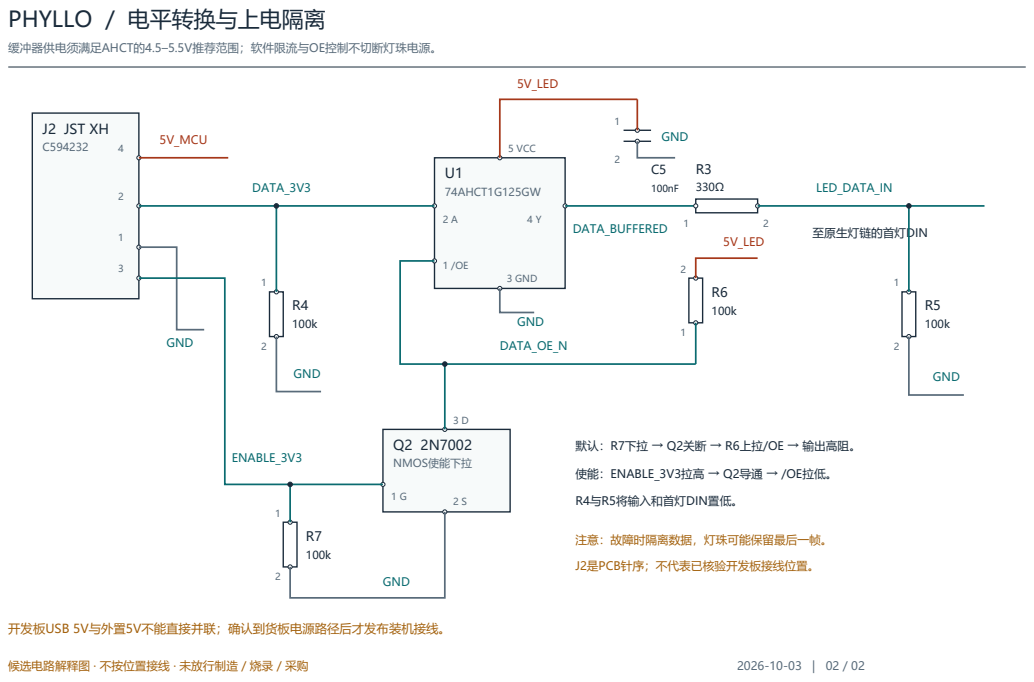
[picture p22: page 2]
