yangwei251003/phyllotaxis/hardware/prototype-v02/manufacturing/back-assembly.pdf

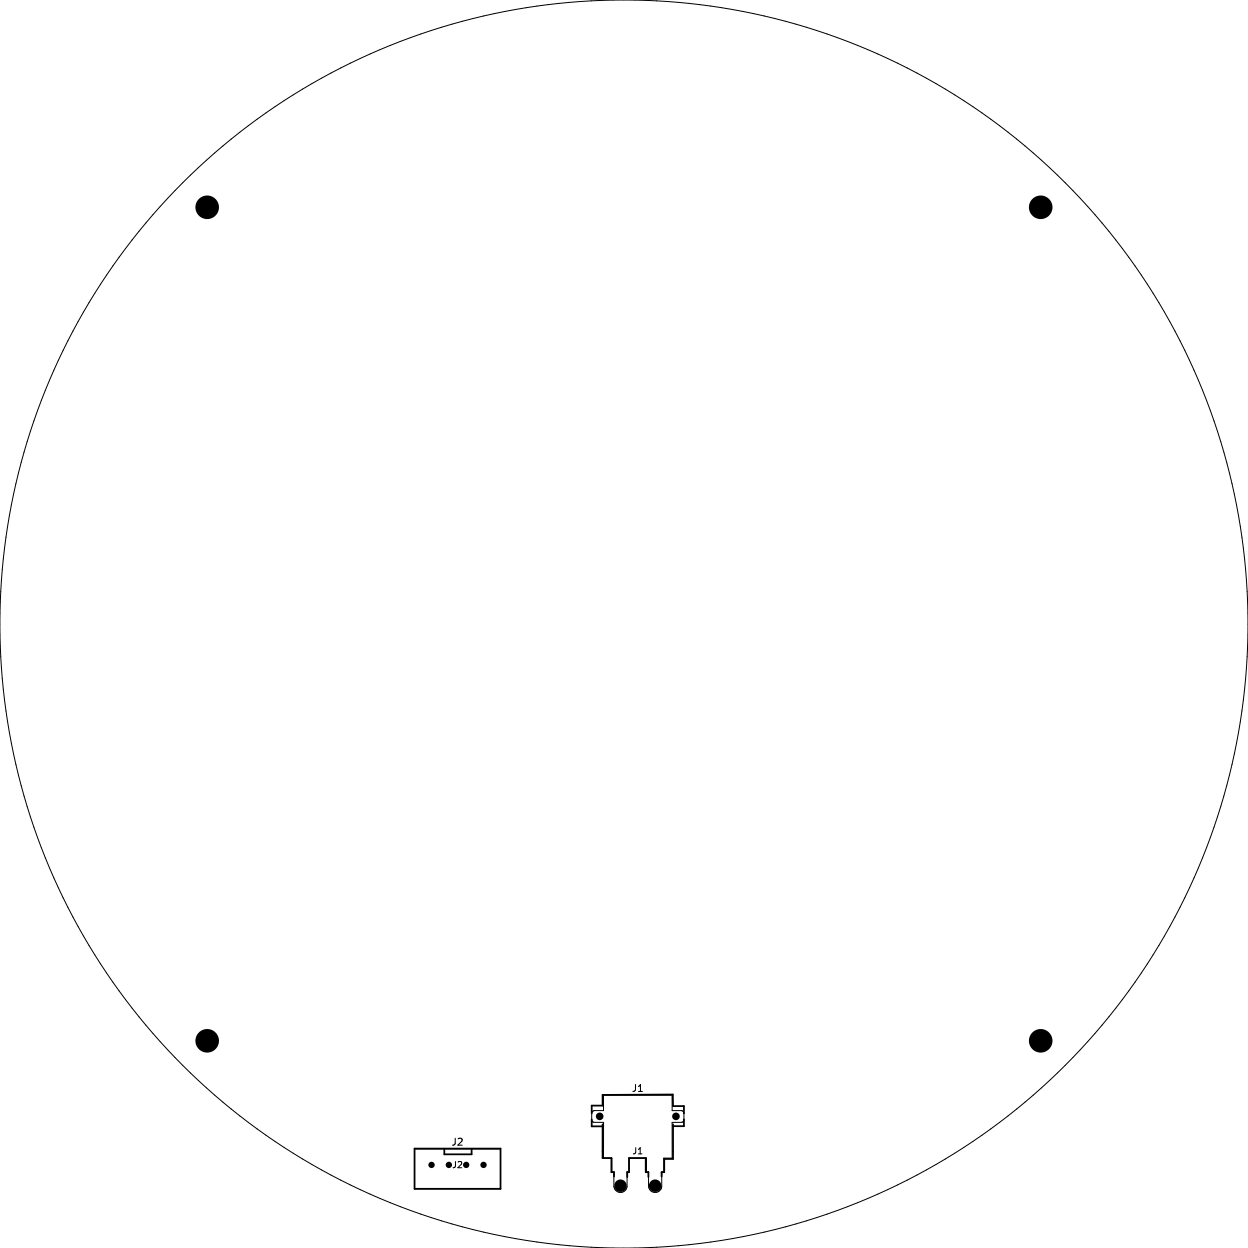
[picture p23: page 1]
