yangwei251003/phyllotaxis/hardware/prototype-v02/manufacturing/front-assembly.pdf

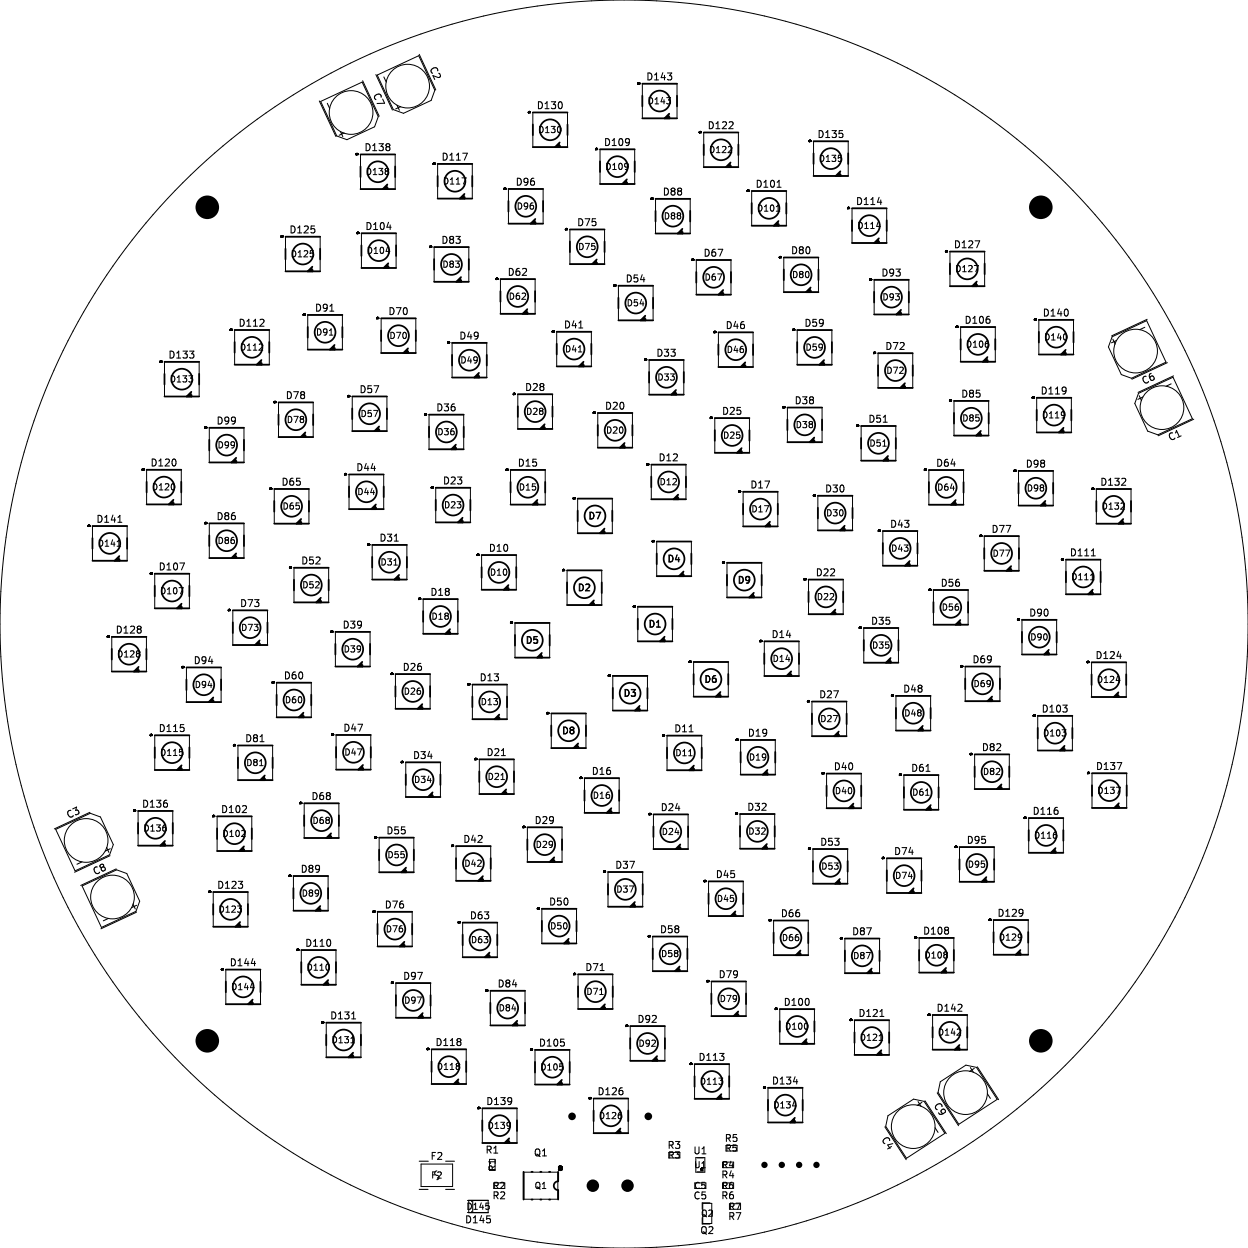
[picture p24: page 1]
