yangwei251003/phyllotaxis/hardware/prototype-v02/manufacturing/front-copper.pdf

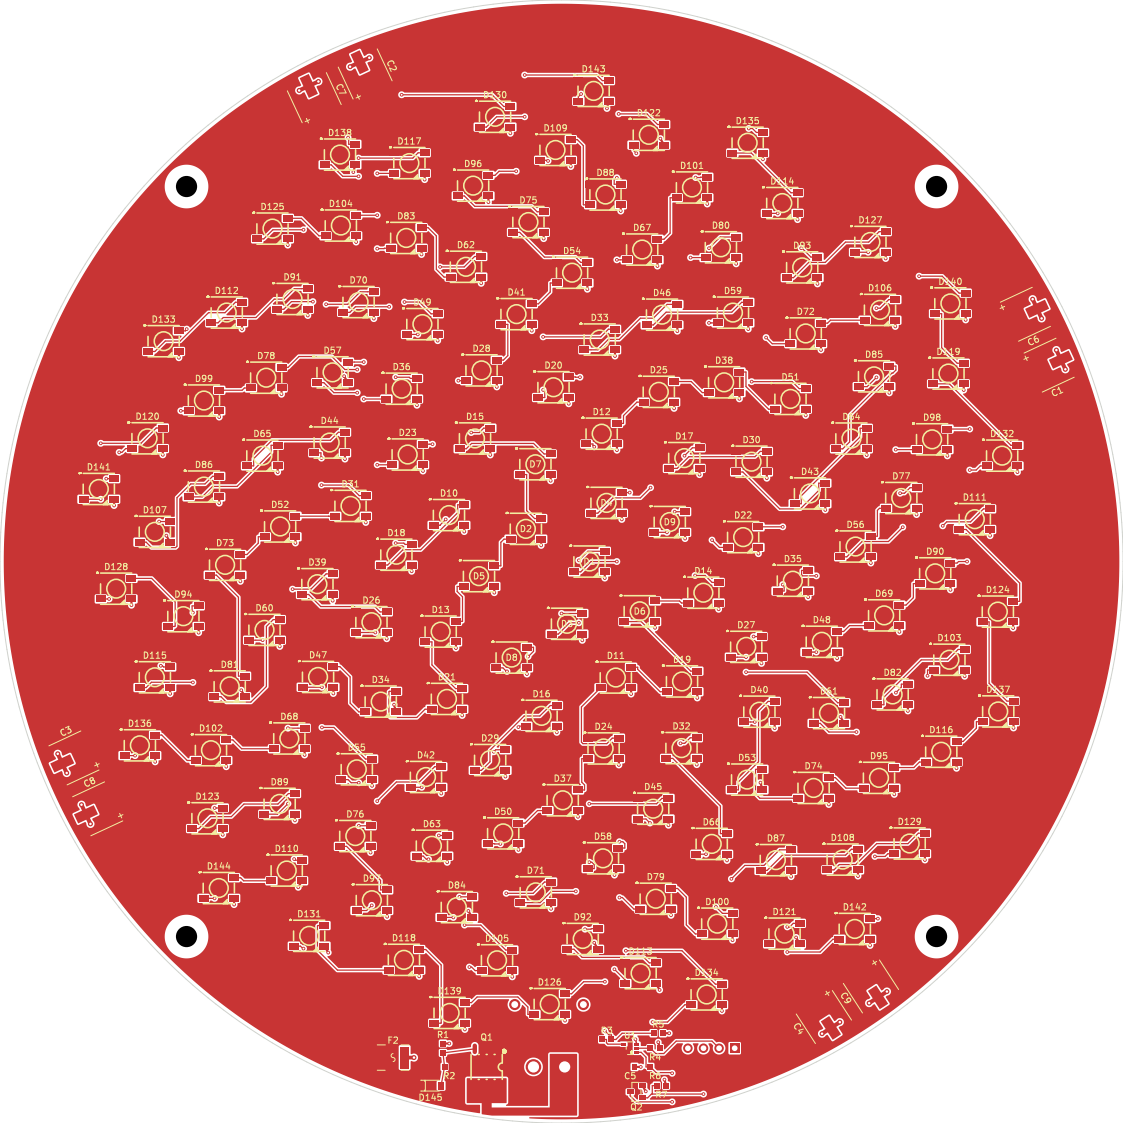
[picture p25: page 1]
