yangwei251003/phyllotaxis/hardware/prototype-v02/manufacturing/front-paste.pdf

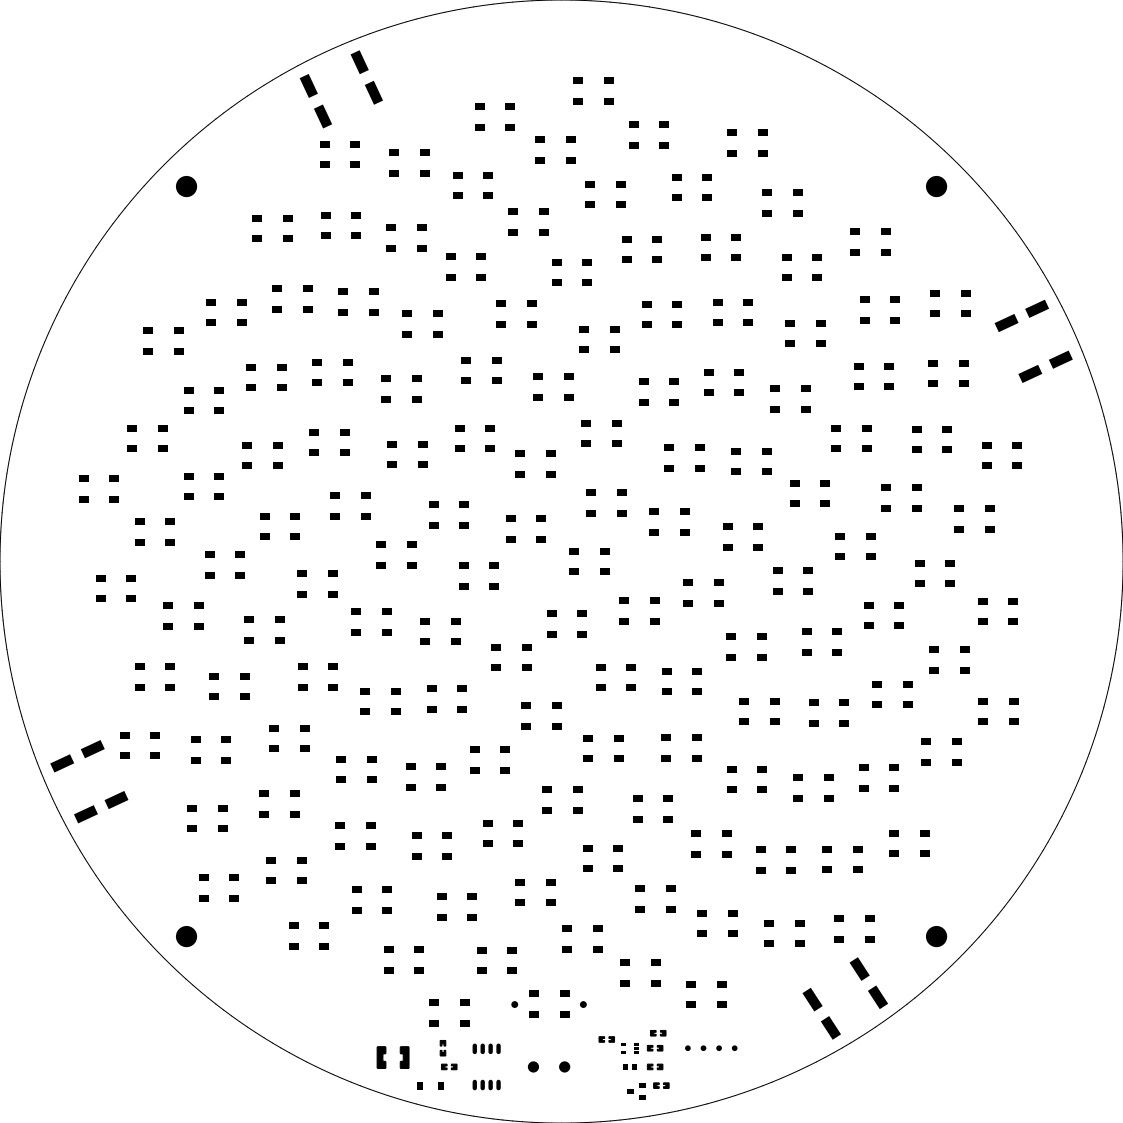
[picture p26: page 1]
