yangwei251003/phyllotaxis/(list of files, drawings)

Other design files:
hardware/routing/phyllo-routing.dsn
hardware/routing/phyllo-signals.dsn
