yangwei251003/phyllotaxis/hardware/kicad-check/phyllo-copper-review.kicad_pcb

## KiCad design hardware/kicad-check/phyllo-copper-review.kicad_pcb (2026-10-26)

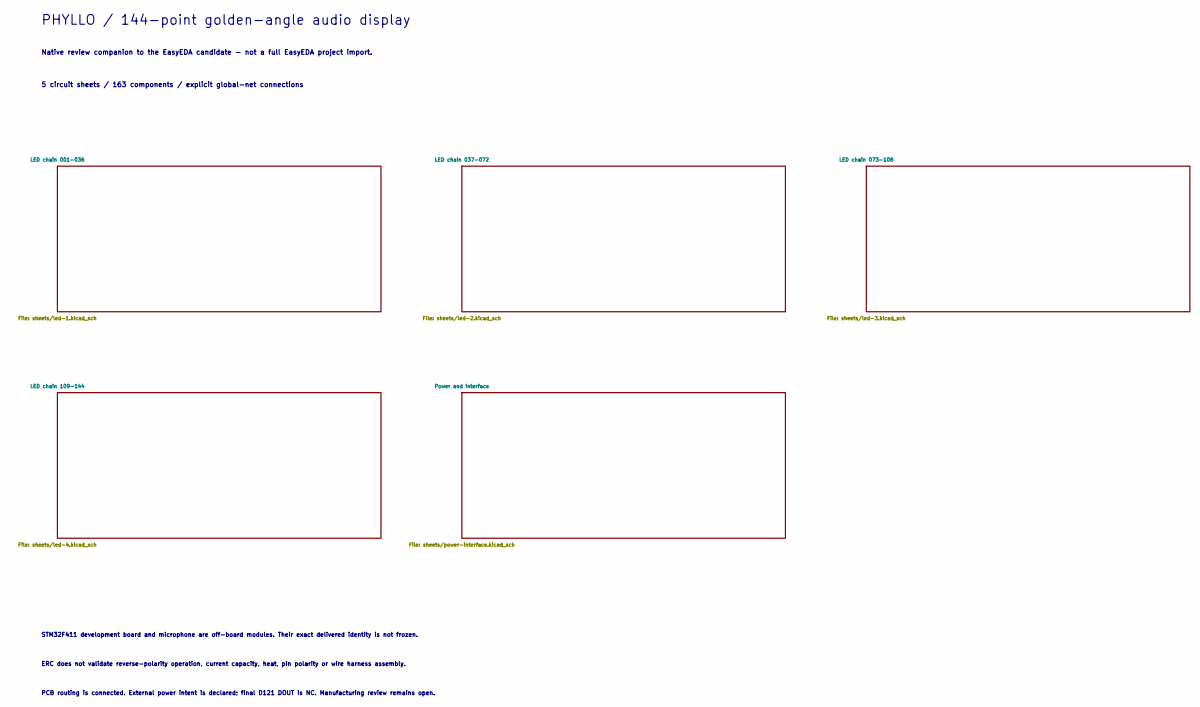
[picture p27: schematic phyllo-copper-review.kicad_sch, PHYLLO / circuit review index]

Notes on the sheet:
PHYLLO / 144-point golden-angle audio display
Native review companion to the EasyEDA candidate - not a full EasyEDA project import.
5 circuit sheets / 163 components / explicit global-net connections
STM32F411 development board and microphone are off-board modules. Their exact delivered identity is not frozen.
ERC does not validate reverse-polarity operation, current capacity, heat, pin polarity or wire harness assembly.
PCB routing is connected. External power intent is declared; final D121 DOUT is NC. Manufacturing review remains open.

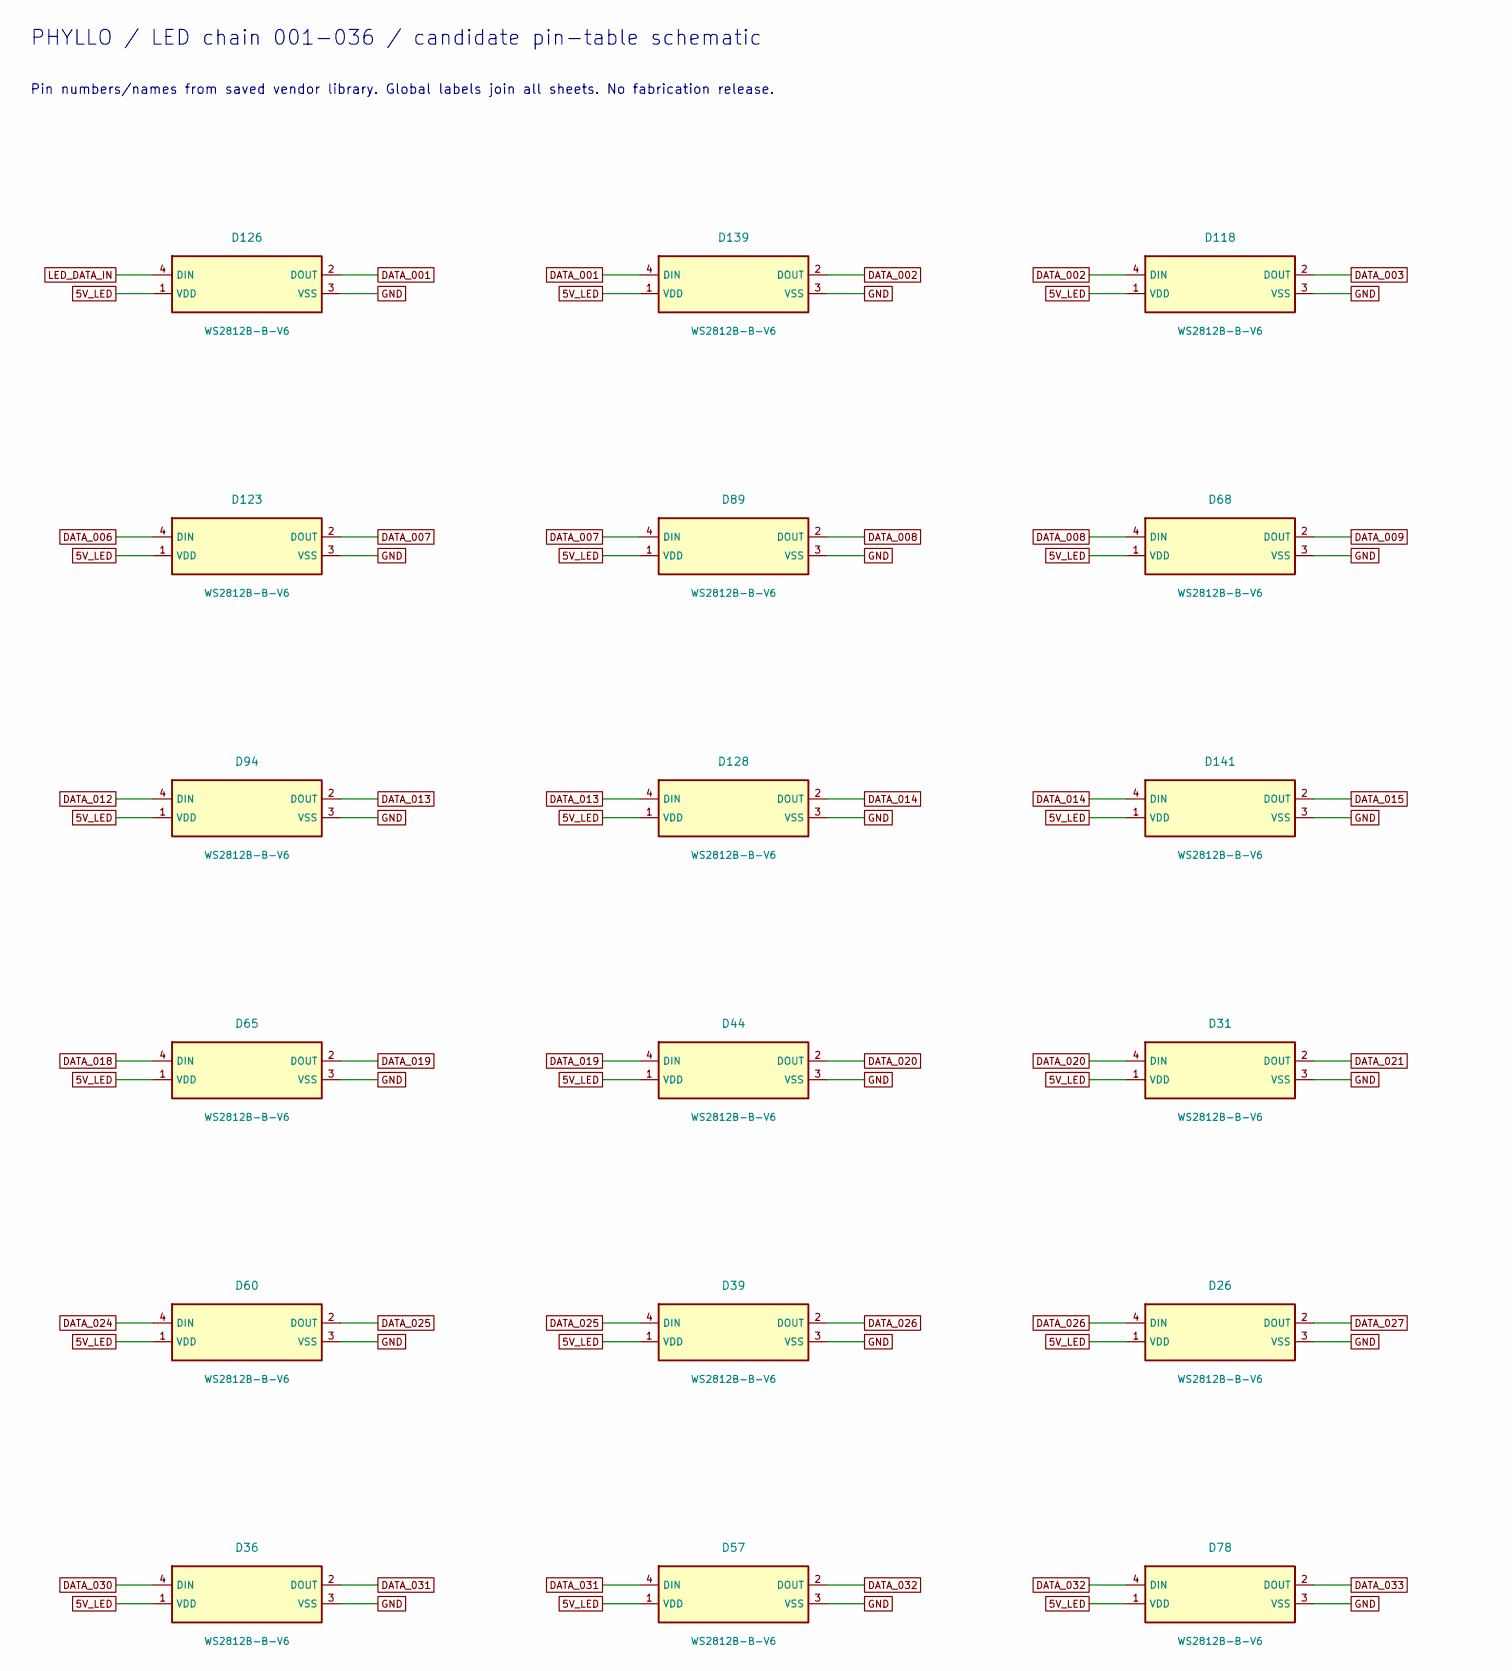
[picture p28: schematic led-1.kicad_sch, LED chain 001-036, part in row 1, column 1]

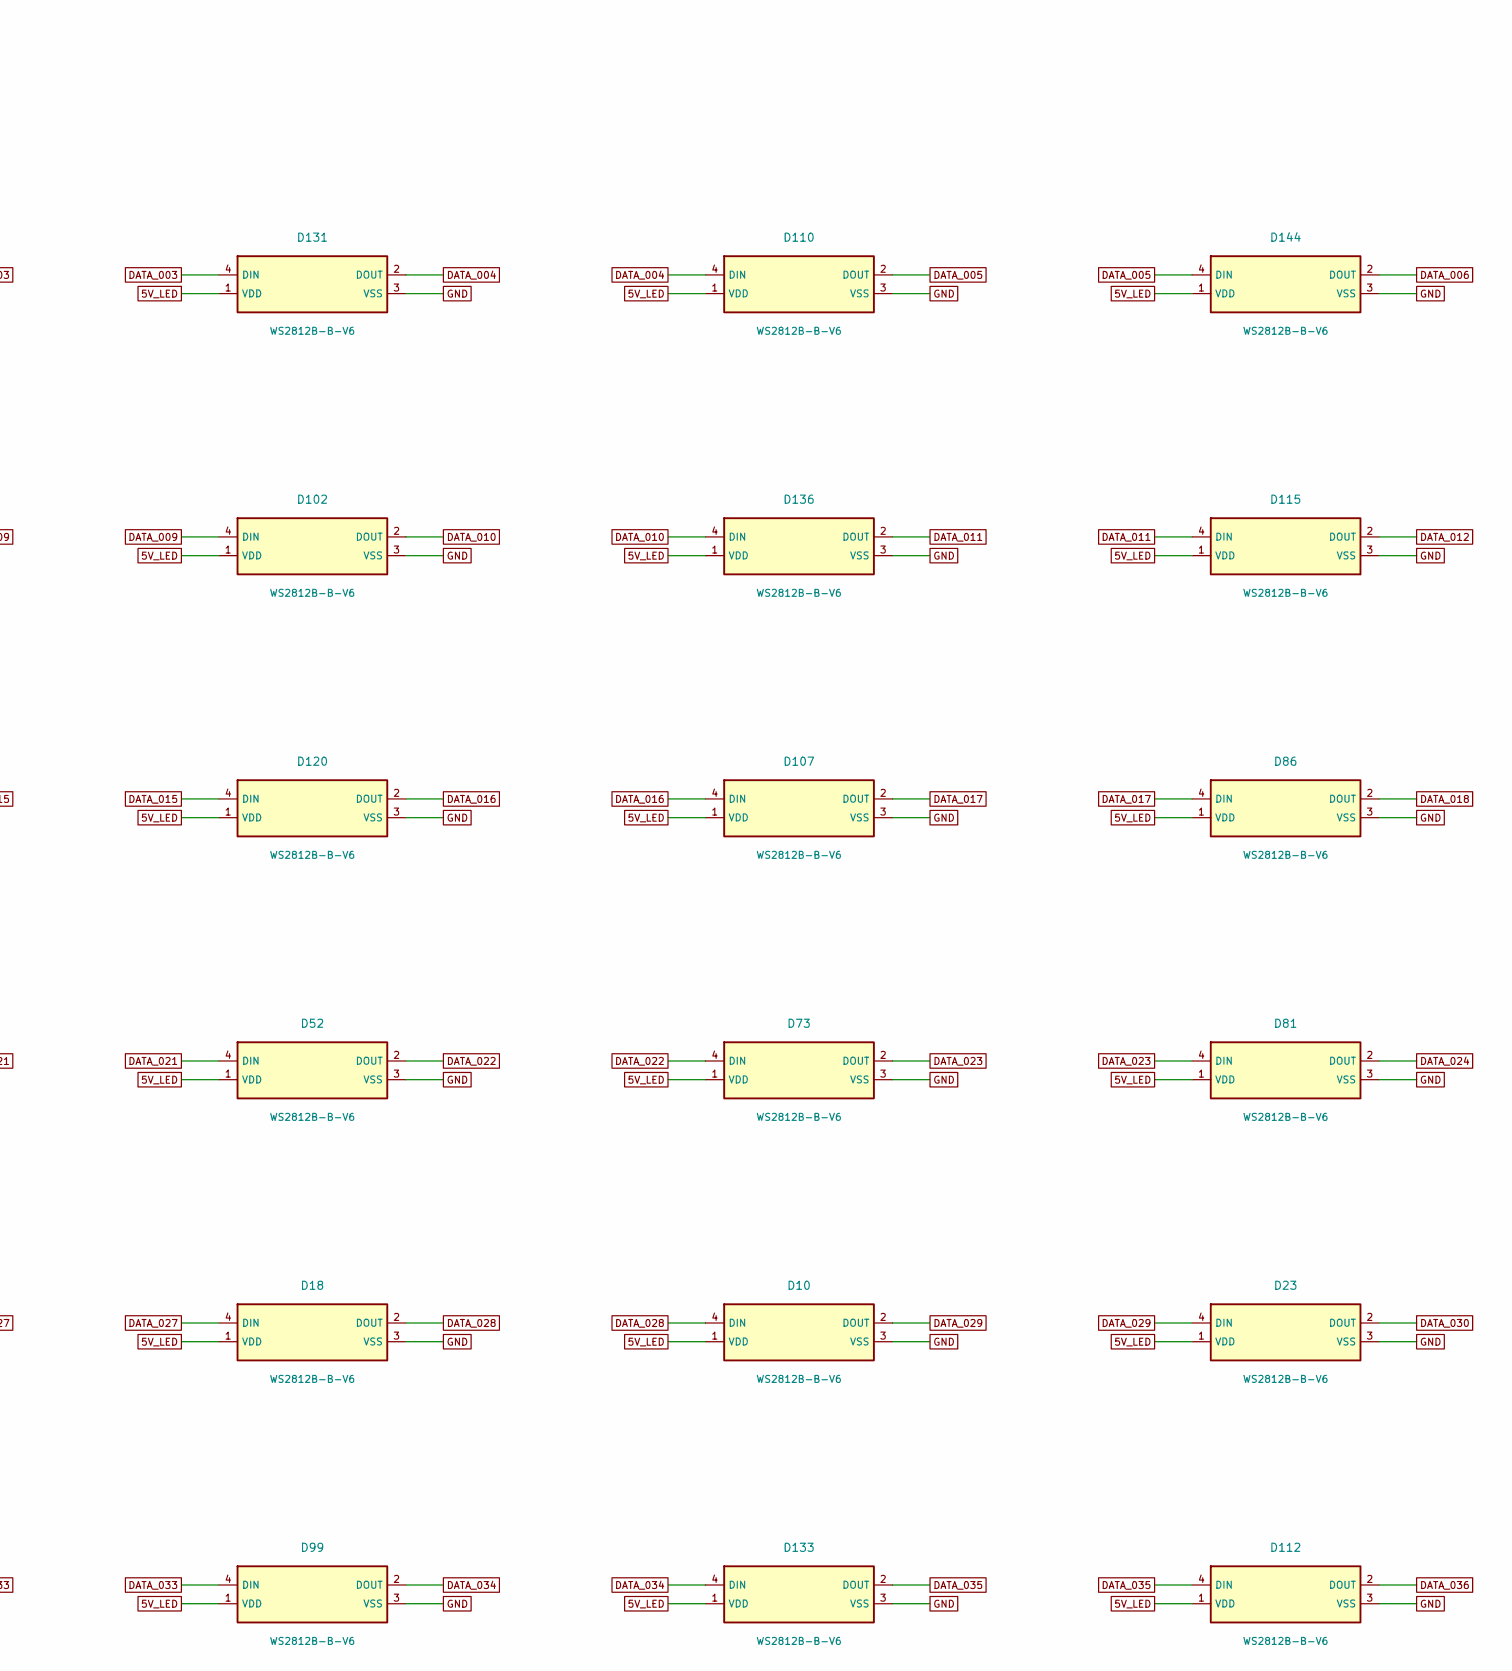
[picture p29: schematic led-1.kicad_sch, LED chain 001-036, part in row 1, column 2]

Parts:
D10, D18, D23, D26, D31, D36, D39, D44, D52, D57, D60, D65, D68, D73, D78, D81, D86, D89, D94, D99, D102, D107, D110, D112, D115, D118, D120, D123, D126, D128, D131, D133, D136, D139, D141, D144: WS2812B-B-V6; C52941391

Connections:
5V_LED: D10.1 (VDD), D18.1 (VDD), D23.1 (VDD), D26.1 (VDD), D31.1 (VDD), D36.1 (VDD), D39.1 (VDD), D44.1 (VDD), D52.1 (VDD), D57.1 (VDD), D60.1 (VDD), D65.1 (VDD), D68.1 (VDD), D73.1 (VDD), D78.1 (VDD), D81.1 (VDD), D86.1 (VDD), D89.1 (VDD), D94.1 (VDD), D99.1 (VDD), D102.1 (VDD), D107.1 (VDD), D110.1 (VDD), D112.1 (VDD), D115.1 (VDD), D118.1 (VDD), D120.1 (VDD), D123.1 (VDD), D126.1 (VDD), D128.1 (VDD), D131.1 (VDD), D133.1 (VDD), D136.1 (VDD), D139.1 (VDD), D141.1 (VDD), D144.1 (VDD); also elsewhere on the board
DATA_001: D126.2 (DOUT), D139.4 (DIN)
DATA_002: D118.4 (DIN), D139.2 (DOUT)
DATA_003: D118.2 (DOUT), D131.4 (DIN)
DATA_004: D110.4 (DIN), D131.2 (DOUT)
DATA_005: D110.2 (DOUT), D144.4 (DIN)
DATA_006: D123.4 (DIN), D144.2 (DOUT)
DATA_007: D89.4 (DIN), D123.2 (DOUT)
DATA_008: D68.4 (DIN), D89.2 (DOUT)
DATA_009: D68.2 (DOUT), D102.4 (DIN)
DATA_010: D102.2 (DOUT), D136.4 (DIN)
DATA_011: D115.4 (DIN), D136.2 (DOUT)
DATA_012: D94.4 (DIN), D115.2 (DOUT)
DATA_013: D94.2 (DOUT), D128.4 (DIN)
DATA_014: D128.2 (DOUT), D141.4 (DIN)
DATA_015: D120.4 (DIN), D141.2 (DOUT)
DATA_016: D107.4 (DIN), D120.2 (DOUT)
DATA_017: D86.4 (DIN), D107.2 (DOUT)
DATA_018: D65.4 (DIN), D86.2 (DOUT)
DATA_019: D44.4 (DIN), D65.2 (DOUT)
DATA_020: D31.4 (DIN), D44.2 (DOUT)
DATA_021: D31.2 (DOUT), D52.4 (DIN)
DATA_022: D52.2 (DOUT), D73.4 (DIN)
DATA_023: D73.2 (DOUT), D81.4 (DIN)
DATA_024: D60.4 (DIN), D81.2 (DOUT)
DATA_025: D39.4 (DIN), D60.2 (DOUT)
DATA_026: D26.4 (DIN), D39.2 (DOUT)
DATA_027: D18.4 (DIN), D26.2 (DOUT)
DATA_028: D10.4 (DIN), D18.2 (DOUT)
DATA_029: D10.2 (DOUT), D23.4 (DIN)
DATA_030: D23.2 (DOUT), D36.4 (DIN)
DATA_031: D36.2 (DOUT), D57.4 (DIN)
DATA_032: D57.2 (DOUT), D78.4 (DIN)
DATA_033: D78.2 (DOUT), D99.4 (DIN)
DATA_034: D99.2 (DOUT), D133.4 (DIN)
DATA_035: D112.4 (DIN), D133.2 (DOUT)
DATA_036: D112.2 (DOUT); also elsewhere on the board
GND: D10.3 (VSS), D18.3 (VSS), D23.3 (VSS), D26.3 (VSS), D31.3 (VSS), D36.3 (VSS), D39.3 (VSS), D44.3 (VSS), D52.3 (VSS), D57.3 (VSS), D60.3 (VSS), D65.3 (VSS), D68.3 (VSS), D73.3 (VSS), D78.3 (VSS), D81.3 (VSS), D86.3 (VSS), D89.3 (VSS), D94.3 (VSS), D99.3 (VSS), D102.3 (VSS), D107.3 (VSS), D110.3 (VSS), D112.3 (VSS), D115.3 (VSS), D118.3 (VSS), D120.3 (VSS), D123.3 (VSS), D126.3 (VSS), D128.3 (VSS), D131.3 (VSS), D133.3 (VSS), D136.3 (VSS), D139.3 (VSS), D141.3 (VSS), D144.3 (VSS); also elsewhere on the board
LED_DATA_IN: D126.4 (DIN); also elsewhere on the board

Notes on the sheet:
PHYLLO / LED chain 001-036 / candidate pin-table schematic
Pin numbers/names from saved vendor library. Global labels join all sheets. No fabrication release.

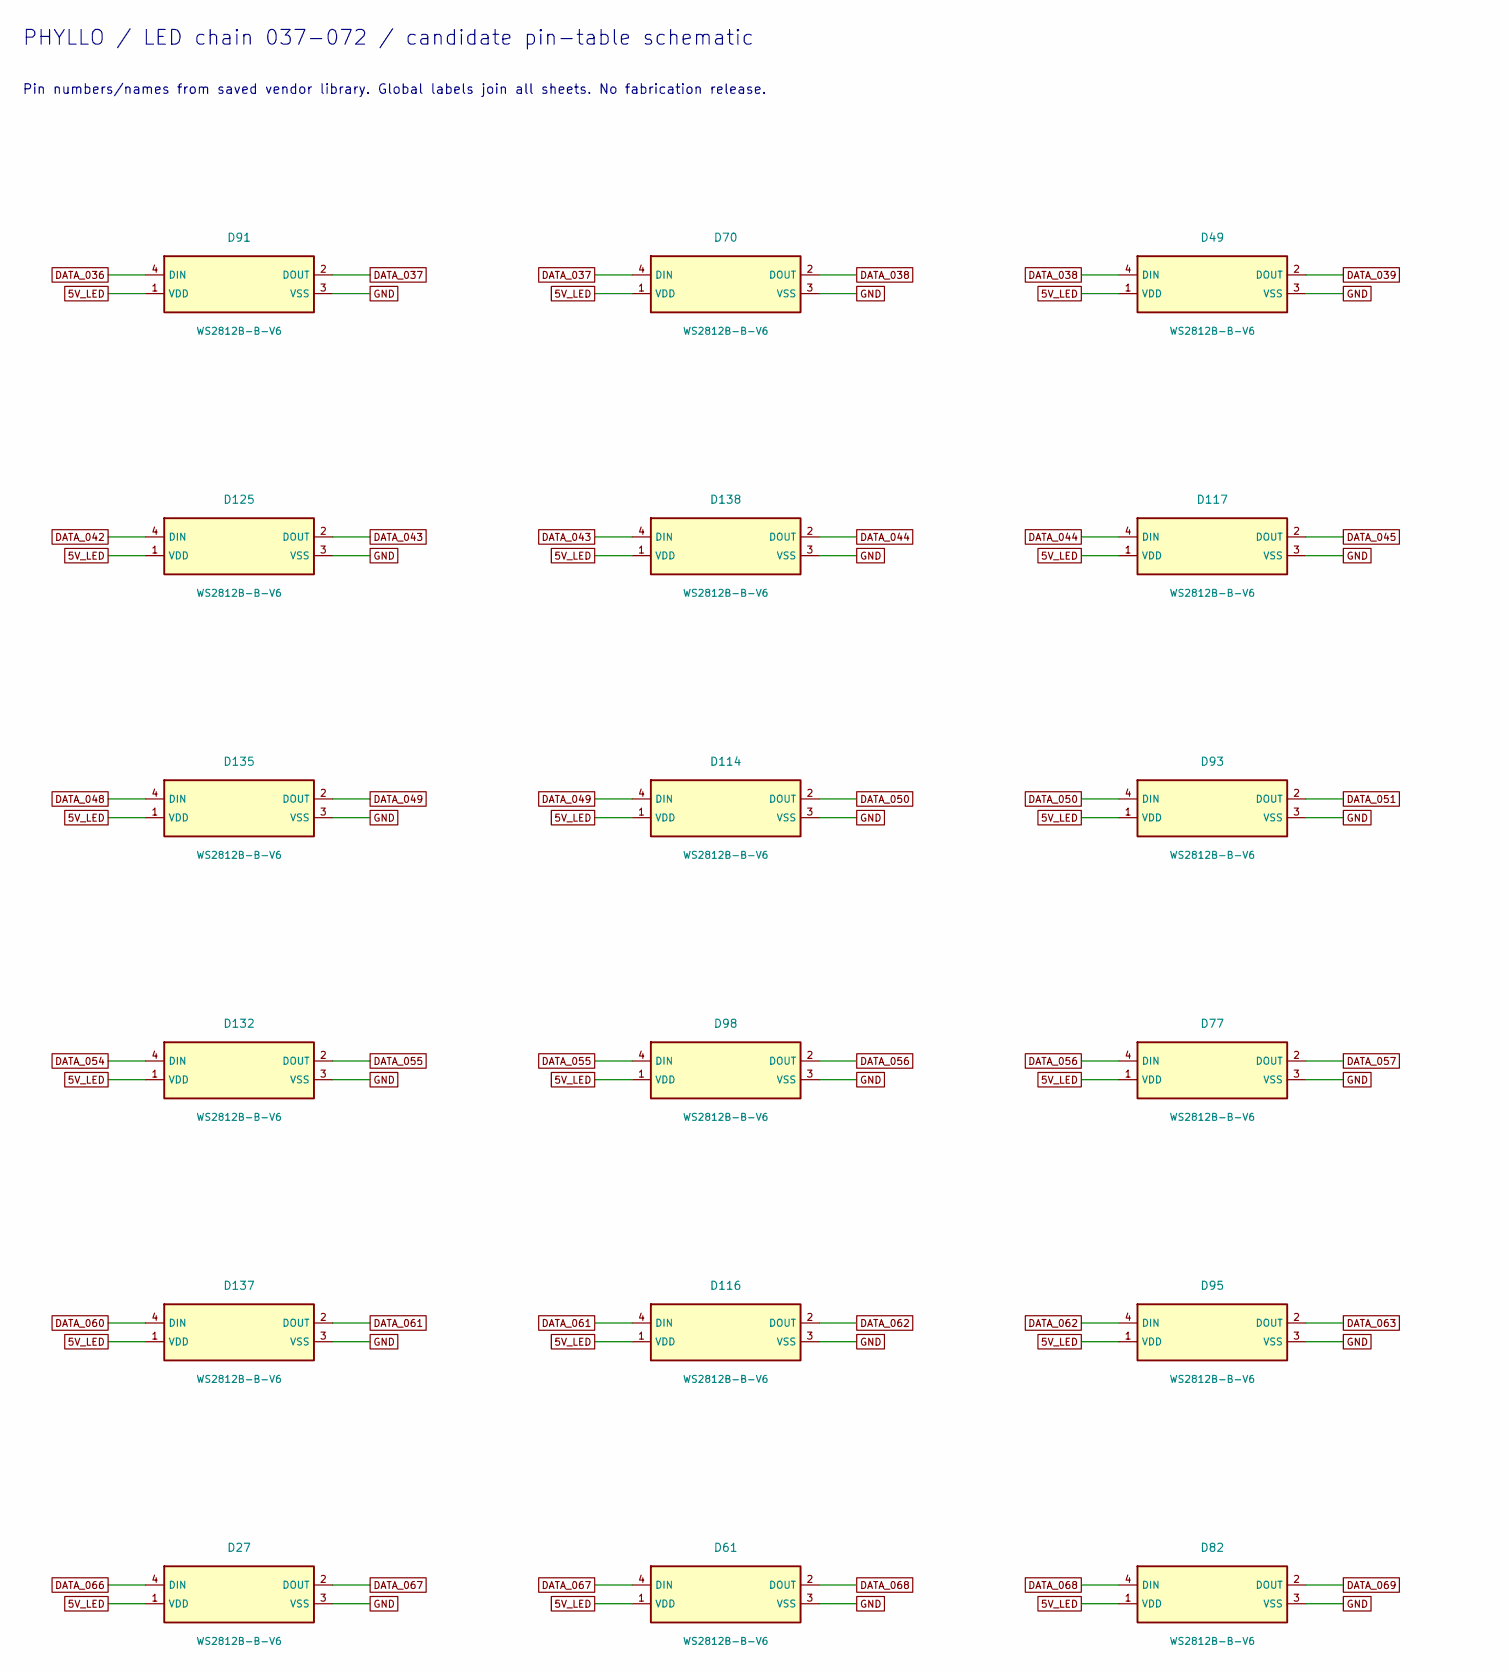
[picture p30: schematic led-2.kicad_sch, LED chain 037-072, part in row 1, column 1]

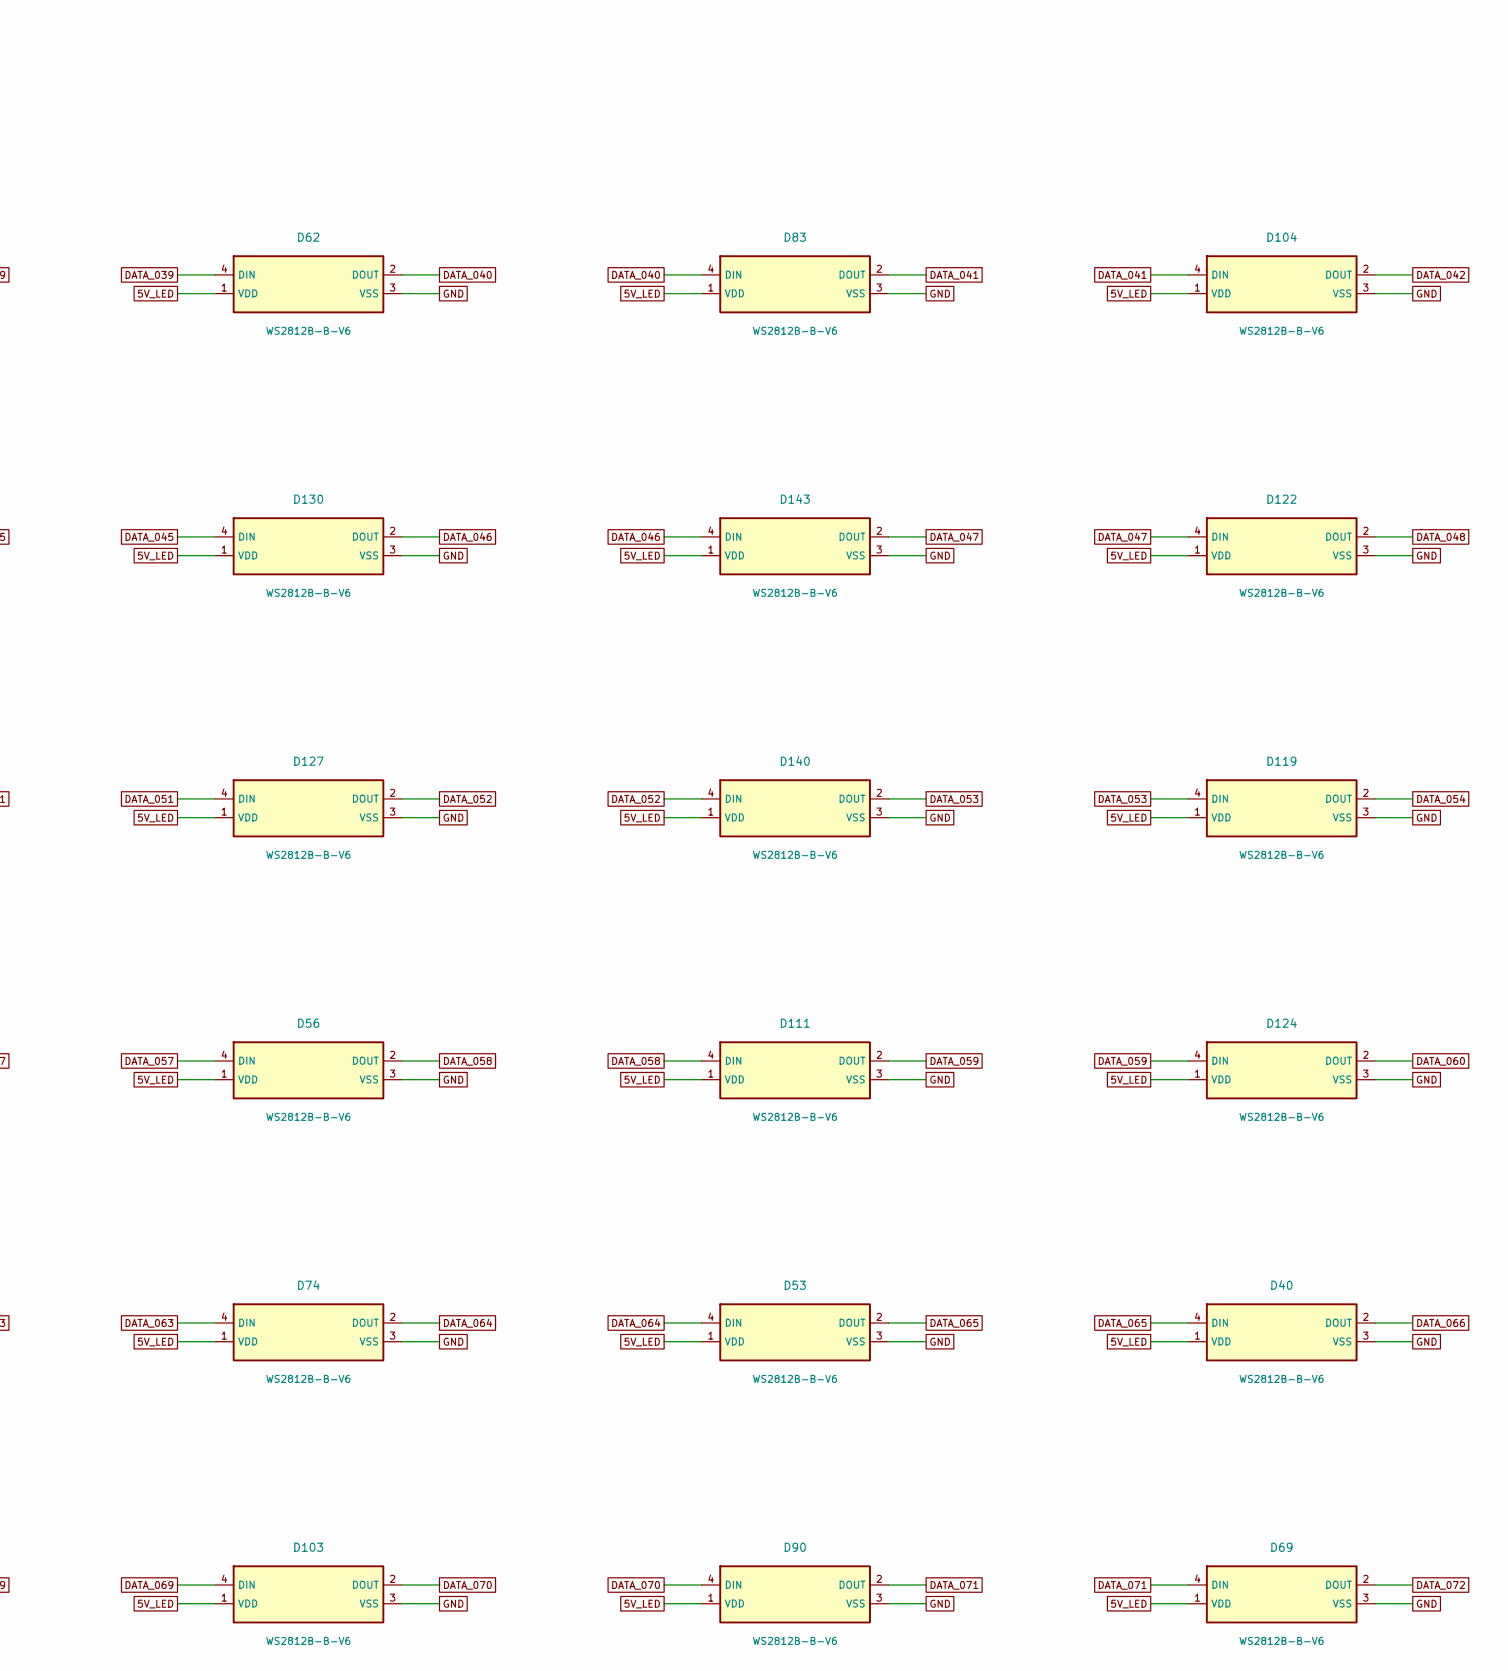
[picture p31: schematic led-2.kicad_sch, LED chain 037-072, part in row 1, column 2]

Parts:
D27, D40, D49, D53, D56, D61, D62, D69, D70, D74, D77, D82, D83, D90, D91, D93, D95, D98, D103, D104, D111, D114, D116, D117, D119, D122, D124, D125, D127, D130, D132, D135, D137, D138, D140, D143: WS2812B-B-V6; C52941391

Connections:
5V_LED: D27.1 (VDD), D40.1 (VDD), D49.1 (VDD), D53.1 (VDD), D56.1 (VDD), D61.1 (VDD), D62.1 (VDD), D69.1 (VDD), D70.1 (VDD), D74.1 (VDD), D77.1 (VDD), D82.1 (VDD), D83.1 (VDD), D90.1 (VDD), D91.1 (VDD), D93.1 (VDD), D95.1 (VDD), D98.1 (VDD), D103.1 (VDD), D104.1 (VDD), D111.1 (VDD), D114.1 (VDD), D116.1 (VDD), D117.1 (VDD), D119.1 (VDD), D122.1 (VDD), D124.1 (VDD), D125.1 (VDD), D127.1 (VDD), D130.1 (VDD), D132.1 (VDD), D135.1 (VDD), D137.1 (VDD), D138.1 (VDD), D140.1 (VDD), D143.1 (VDD); also elsewhere on the board
DATA_036: D91.4 (DIN); also elsewhere on the board
DATA_037: D70.4 (DIN), D91.2 (DOUT)
DATA_038: D49.4 (DIN), D70.2 (DOUT)
DATA_039: D49.2 (DOUT), D62.4 (DIN)
DATA_040: D62.2 (DOUT), D83.4 (DIN)
DATA_041: D83.2 (DOUT), D104.4 (DIN)
DATA_042: D104.2 (DOUT), D125.4 (DIN)
DATA_043: D125.2 (DOUT), D138.4 (DIN)
DATA_044: D117.4 (DIN), D138.2 (DOUT)
DATA_045: D117.2 (DOUT), D130.4 (DIN)
DATA_046: D130.2 (DOUT), D143.4 (DIN)
DATA_047: D122.4 (DIN), D143.2 (DOUT)
DATA_048: D122.2 (DOUT), D135.4 (DIN)
DATA_049: D114.4 (DIN), D135.2 (DOUT)
DATA_050: D93.4 (DIN), D114.2 (DOUT)
DATA_051: D93.2 (DOUT), D127.4 (DIN)
DATA_052: D127.2 (DOUT), D140.4 (DIN)
DATA_053: D119.4 (DIN), D140.2 (DOUT)
DATA_054: D119.2 (DOUT), D132.4 (DIN)
DATA_055: D98.4 (DIN), D132.2 (DOUT)
DATA_056: D77.4 (DIN), D98.2 (DOUT)
DATA_057: D56.4 (DIN), D77.2 (DOUT)
DATA_058: D56.2 (DOUT), D111.4 (DIN)
DATA_059: D111.2 (DOUT), D124.4 (DIN)
DATA_060: D124.2 (DOUT), D137.4 (DIN)
DATA_061: D116.4 (DIN), D137.2 (DOUT)
DATA_062: D95.4 (DIN), D116.2 (DOUT)
DATA_063: D74.4 (DIN), D95.2 (DOUT)
DATA_064: D53.4 (DIN), D74.2 (DOUT)
DATA_065: D40.4 (DIN), D53.2 (DOUT)
DATA_066: D27.4 (DIN), D40.2 (DOUT)
DATA_067: D27.2 (DOUT), D61.4 (DIN)
DATA_068: D61.2 (DOUT), D82.4 (DIN)
DATA_069: D82.2 (DOUT), D103.4 (DIN)
DATA_070: D90.4 (DIN), D103.2 (DOUT)
DATA_071: D69.4 (DIN), D90.2 (DOUT)
DATA_072: D69.2 (DOUT); also elsewhere on the board
GND: D27.3 (VSS), D40.3 (VSS), D49.3 (VSS), D53.3 (VSS), D56.3 (VSS), D61.3 (VSS), D62.3 (VSS), D69.3 (VSS), D70.3 (VSS), D74.3 (VSS), D77.3 (VSS), D82.3 (VSS), D83.3 (VSS), D90.3 (VSS), D91.3 (VSS), D93.3 (VSS), D95.3 (VSS), D98.3 (VSS), D103.3 (VSS), D104.3 (VSS), D111.3 (VSS), D114.3 (VSS), D116.3 (VSS), D117.3 (VSS), D119.3 (VSS), D122.3 (VSS), D124.3 (VSS), D125.3 (VSS), D127.3 (VSS), D130.3 (VSS), D132.3 (VSS), D135.3 (VSS), D137.3 (VSS), D138.3 (VSS), D140.3 (VSS), D143.3 (VSS); also elsewhere on the board

Notes on the sheet:
PHYLLO / LED chain 037-072 / candidate pin-table schematic
Pin numbers/names from saved vendor library. Global labels join all sheets. No fabrication release.

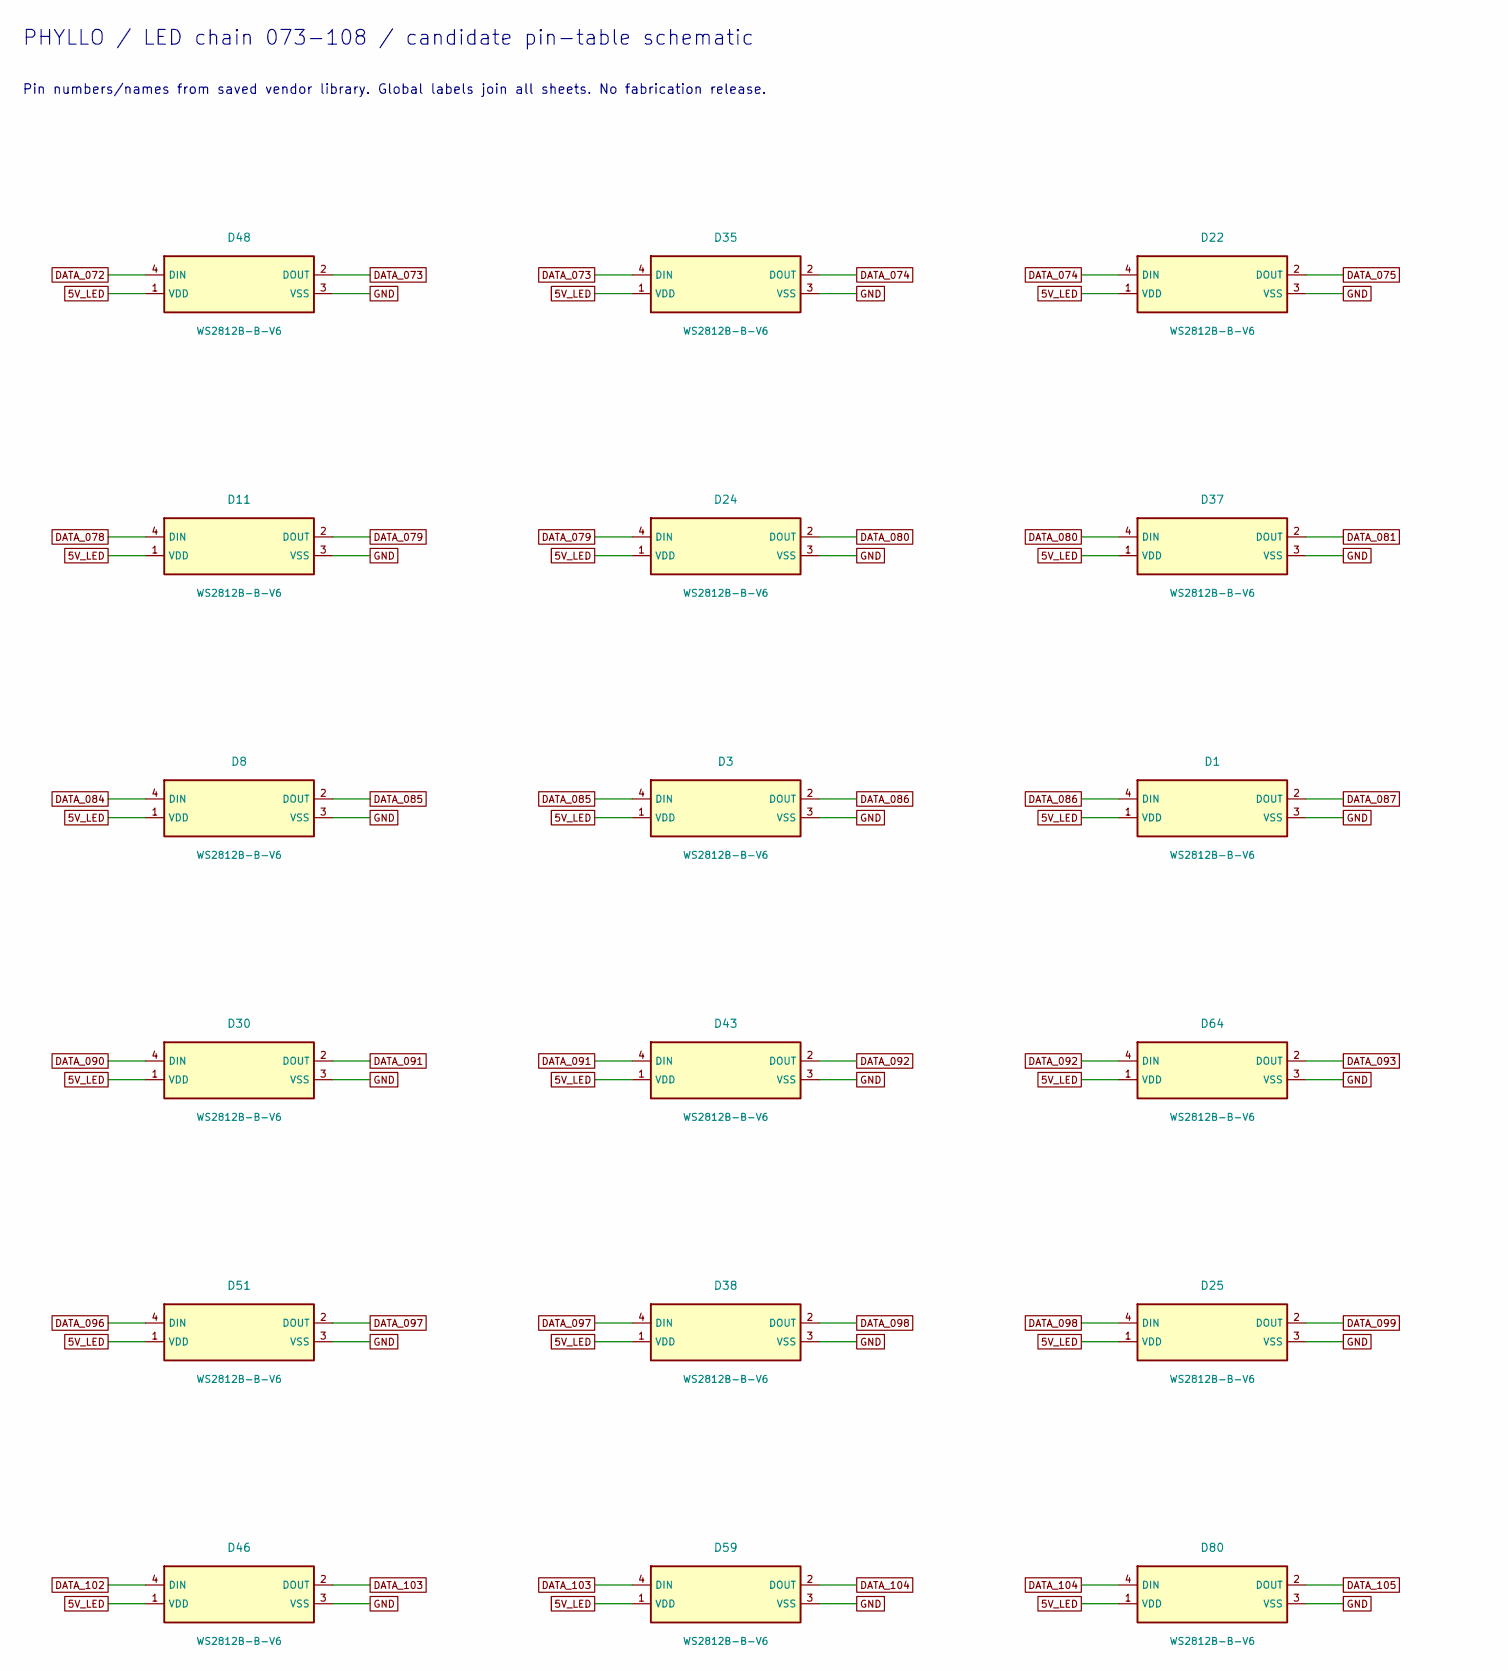
[picture p32: schematic led-3.kicad_sch, LED chain 073-108, part in row 1, column 1]

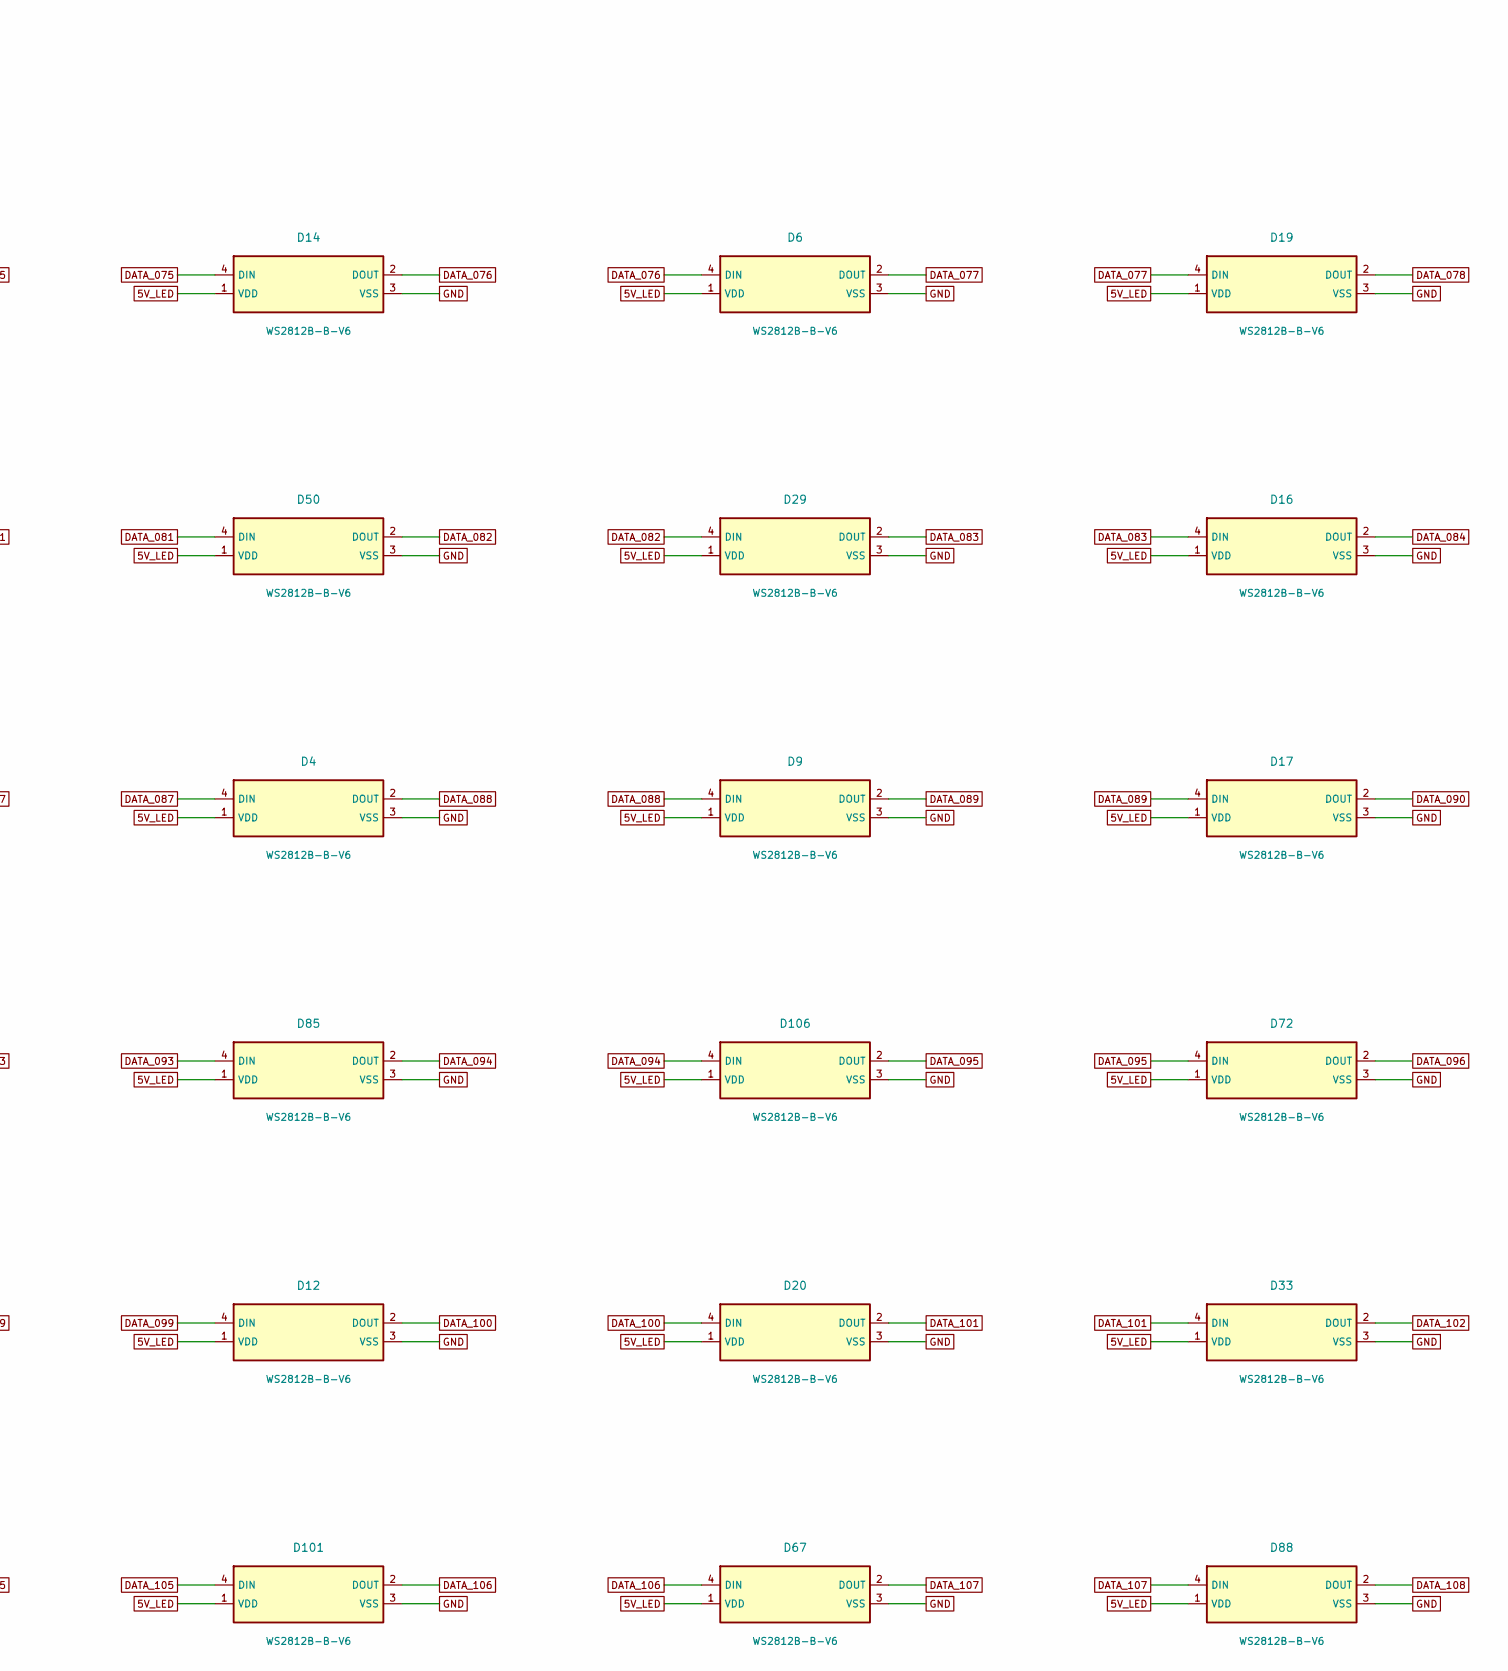
[picture p33: schematic led-3.kicad_sch, LED chain 073-108, part in row 1, column 2]

Parts:
D1, D3, D4, D6, D8, D9, D11, D12, D14, D16, D17, D19, D20, D22, D24, D25, D29, D30, D33, D35, D37, D38, D43, D46, D48, D50, D51, D59, D64, D67, D72, D80, D85, D88, D101, D106: WS2812B-B-V6; C52941391

Connections:
5V_LED: D1.1 (VDD), D3.1 (VDD), D4.1 (VDD), D6.1 (VDD), D8.1 (VDD), D9.1 (VDD), D11.1 (VDD), D12.1 (VDD), D14.1 (VDD), D16.1 (VDD), D17.1 (VDD), D19.1 (VDD), D20.1 (VDD), D22.1 (VDD), D24.1 (VDD), D25.1 (VDD), D29.1 (VDD), D30.1 (VDD), D33.1 (VDD), D35.1 (VDD), D37.1 (VDD), D38.1 (VDD), D43.1 (VDD), D46.1 (VDD), D48.1 (VDD), D50.1 (VDD), D51.1 (VDD), D59.1 (VDD), D64.1 (VDD), D67.1 (VDD), D72.1 (VDD), D80.1 (VDD), D85.1 (VDD), D88.1 (VDD), D101.1 (VDD), D106.1 (VDD); also elsewhere on the board
DATA_072: D48.4 (DIN); also elsewhere on the board
DATA_073: D35.4 (DIN), D48.2 (DOUT)
DATA_074: D22.4 (DIN), D35.2 (DOUT)
DATA_075: D14.4 (DIN), D22.2 (DOUT)
DATA_076: D6.4 (DIN), D14.2 (DOUT)
DATA_077: D6.2 (DOUT), D19.4 (DIN)
DATA_078: D11.4 (DIN), D19.2 (DOUT)
DATA_079: D11.2 (DOUT), D24.4 (DIN)
DATA_080: D24.2 (DOUT), D37.4 (DIN)
DATA_081: D37.2 (DOUT), D50.4 (DIN)
DATA_082: D29.4 (DIN), D50.2 (DOUT)
DATA_083: D16.4 (DIN), D29.2 (DOUT)
DATA_084: D8.4 (DIN), D16.2 (DOUT)
DATA_085: D3.4 (DIN), D8.2 (DOUT)
DATA_086: D1.4 (DIN), D3.2 (DOUT)
DATA_087: D1.2 (DOUT), D4.4 (DIN)
DATA_088: D4.2 (DOUT), D9.4 (DIN)
DATA_089: D9.2 (DOUT), D17.4 (DIN)
DATA_090: D17.2 (DOUT), D30.4 (DIN)
DATA_091: D30.2 (DOUT), D43.4 (DIN)
DATA_092: D43.2 (DOUT), D64.4 (DIN)
DATA_093: D64.2 (DOUT), D85.4 (DIN)
DATA_094: D85.2 (DOUT), D106.4 (DIN)
DATA_095: D72.4 (DIN), D106.2 (DOUT)
DATA_096: D51.4 (DIN), D72.2 (DOUT)
DATA_097: D38.4 (DIN), D51.2 (DOUT)
DATA_098: D25.4 (DIN), D38.2 (DOUT)
DATA_099: D12.4 (DIN), D25.2 (DOUT)
DATA_100: D12.2 (DOUT), D20.4 (DIN)
DATA_101: D20.2 (DOUT), D33.4 (DIN)
DATA_102: D33.2 (DOUT), D46.4 (DIN)
DATA_103: D46.2 (DOUT), D59.4 (DIN)
DATA_104: D59.2 (DOUT), D80.4 (DIN)
DATA_105: D80.2 (DOUT), D101.4 (DIN)
DATA_106: D67.4 (DIN), D101.2 (DOUT)
DATA_107: D67.2 (DOUT), D88.4 (DIN)
DATA_108: D88.2 (DOUT); also elsewhere on the board
GND: D1.3 (VSS), D3.3 (VSS), D4.3 (VSS), D6.3 (VSS), D8.3 (VSS), D9.3 (VSS), D11.3 (VSS), D12.3 (VSS), D14.3 (VSS), D16.3 (VSS), D17.3 (VSS), D19.3 (VSS), D20.3 (VSS), D22.3 (VSS), D24.3 (VSS), D25.3 (VSS), D29.3 (VSS), D30.3 (VSS), D33.3 (VSS), D35.3 (VSS), D37.3 (VSS), D38.3 (VSS), D43.3 (VSS), D46.3 (VSS), D48.3 (VSS), D50.3 (VSS), D51.3 (VSS), D59.3 (VSS), D64.3 (VSS), D67.3 (VSS), D72.3 (VSS), D80.3 (VSS), D85.3 (VSS), D88.3 (VSS), D101.3 (VSS), D106.3 (VSS); also elsewhere on the board

Notes on the sheet:
PHYLLO / LED chain 073-108 / candidate pin-table schematic
Pin numbers/names from saved vendor library. Global labels join all sheets. No fabrication release.
