yangwei251003/phyllotaxis/hardware/kicad-check/phyllo-copper-review.kicad_pcb

## KiCad design hardware/kicad-check/phyllo-copper-review.kicad_pcb (continued)

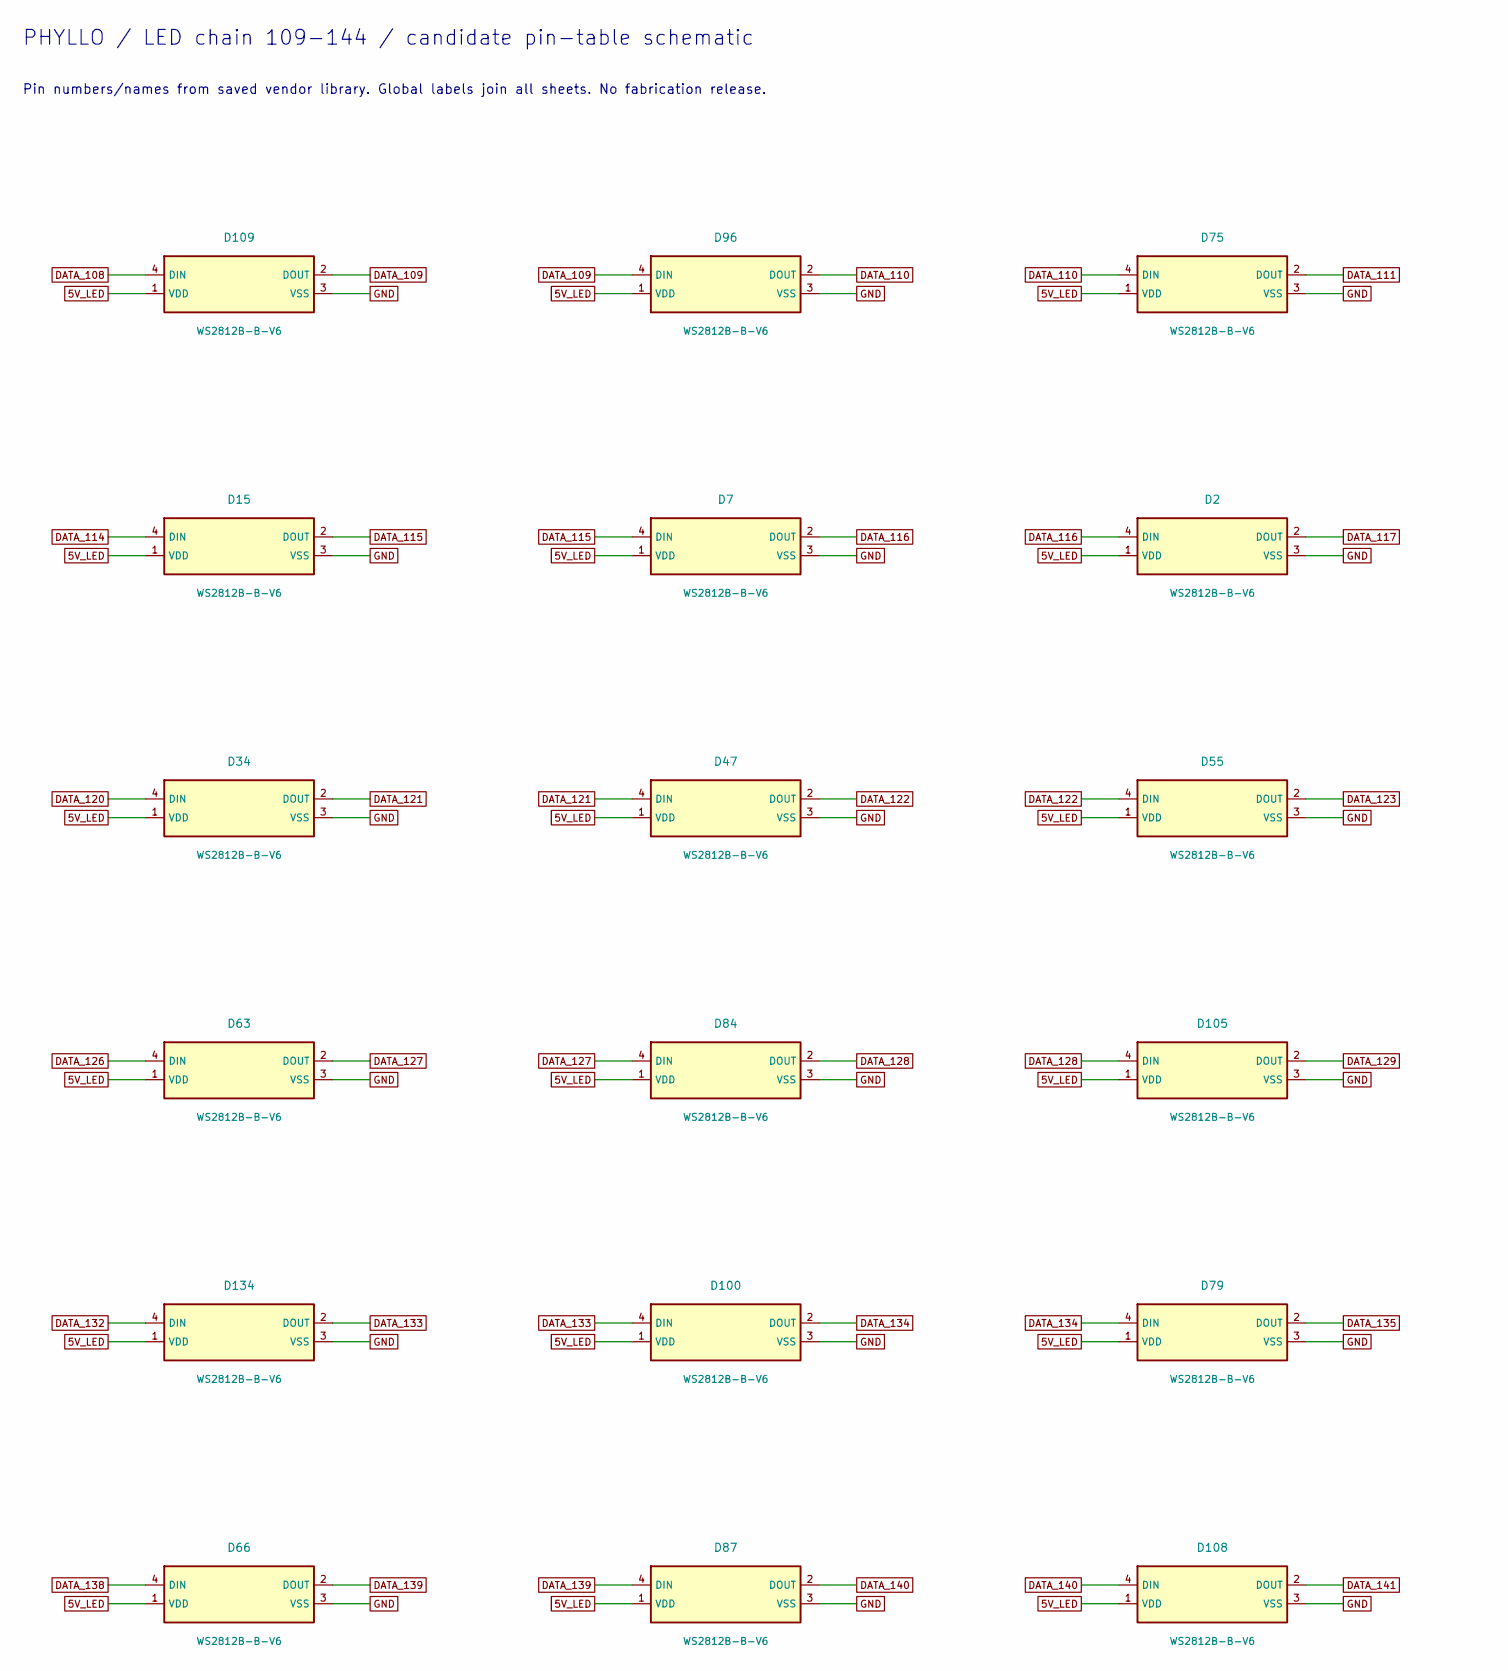
[picture p34: schematic led-4.kicad_sch, LED chain 109-144, part in row 1, column 1]

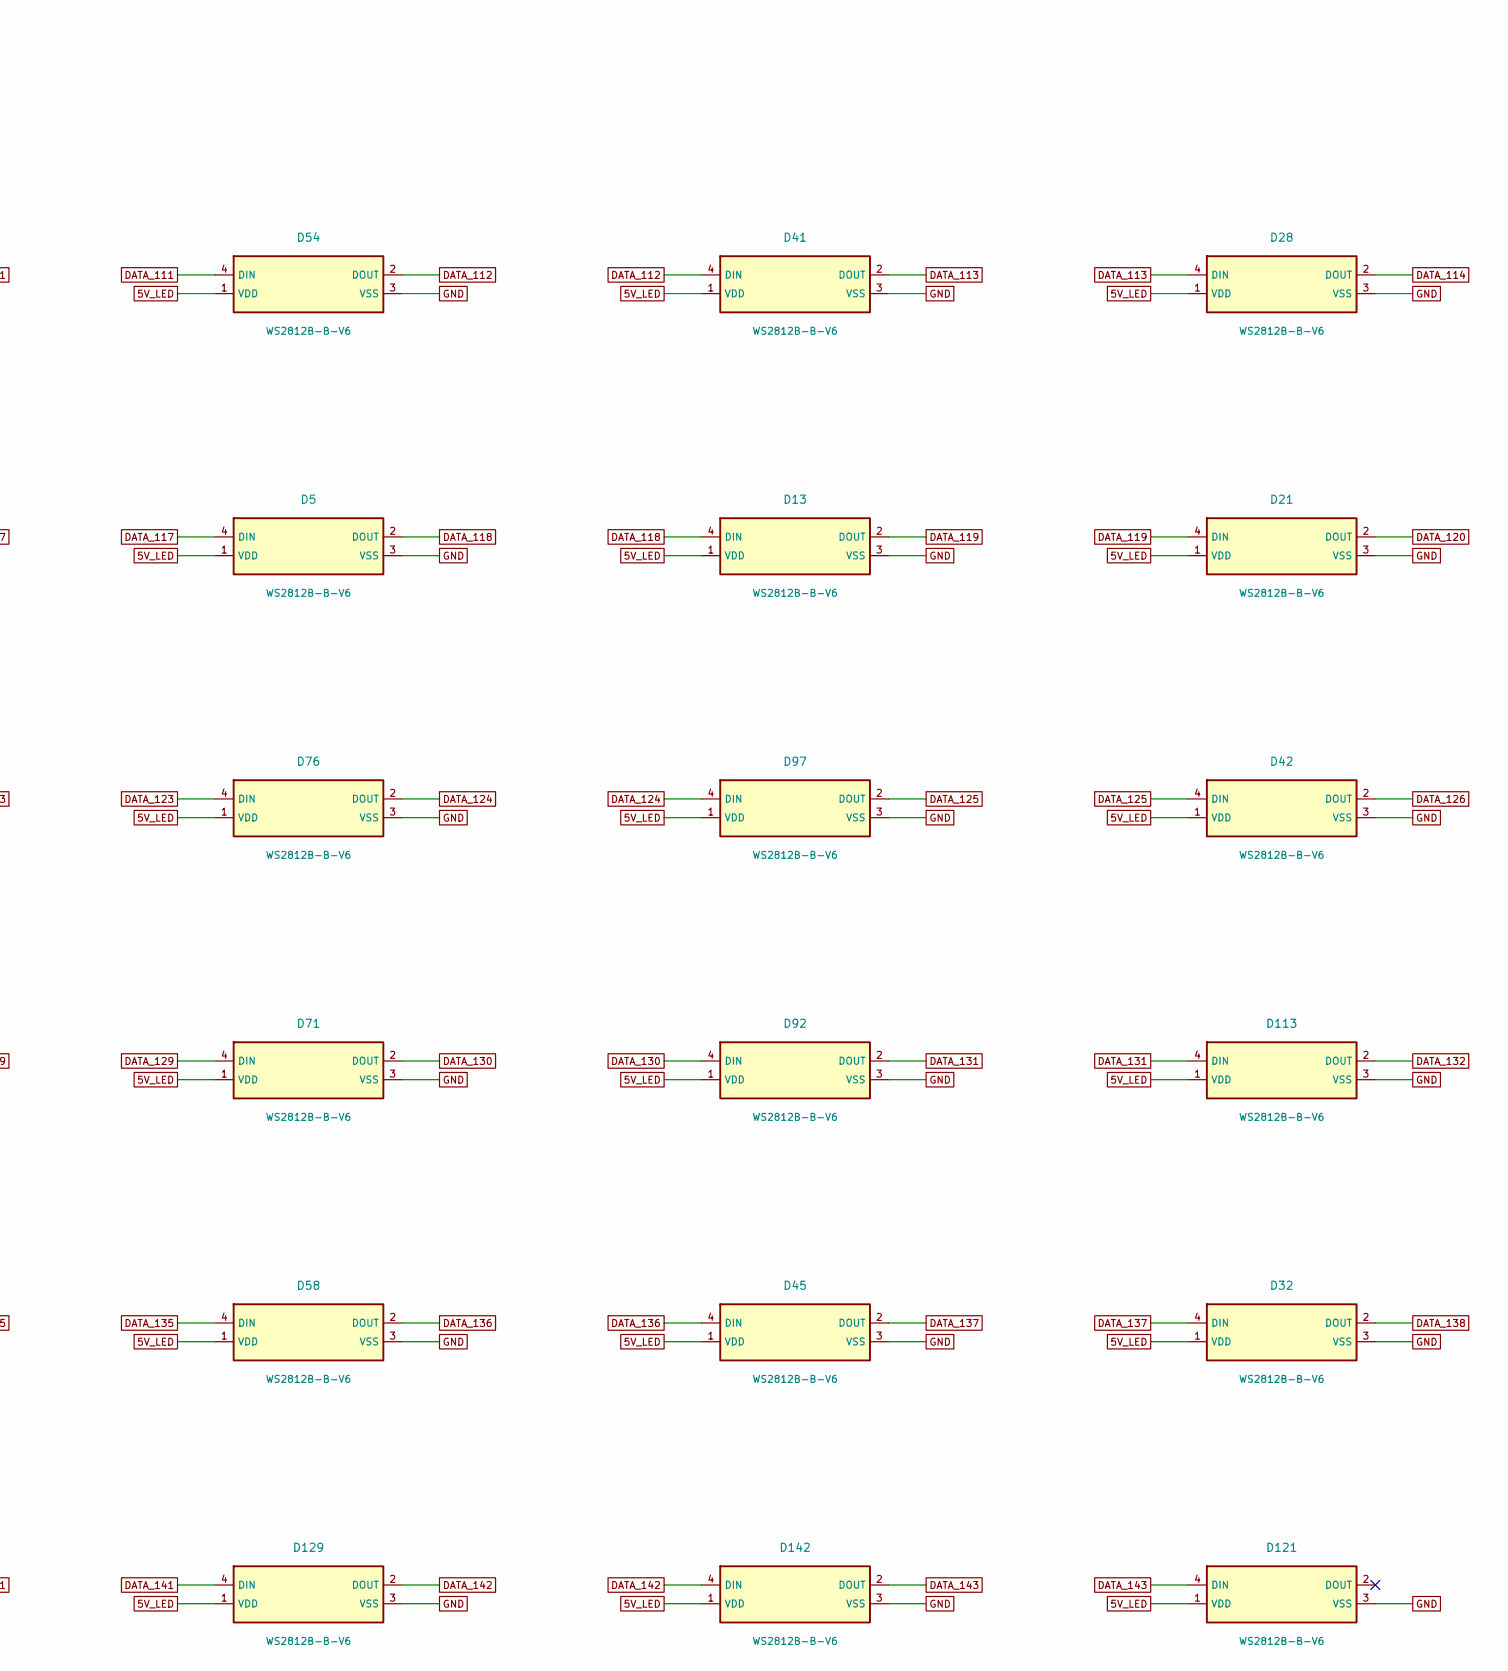
[picture p35: schematic led-4.kicad_sch, LED chain 109-144, part in row 1, column 2]

Parts:
D2, D5, D7, D13, D15, D21, D28, D32, D34, D41, D42, D45, D47, D54, D55, D58, D63, D66, D71, D75, D76, D79, D84, D87, D92, D96, D97, D100, D105, D108, D109, D113, D121, D129, D134, D142: WS2812B-B-V6; C52941391

Connections:
5V_LED: D2.1 (VDD), D5.1 (VDD), D7.1 (VDD), D13.1 (VDD), D15.1 (VDD), D21.1 (VDD), D28.1 (VDD), D32.1 (VDD), D34.1 (VDD), D41.1 (VDD), D42.1 (VDD), D45.1 (VDD), D47.1 (VDD), D54.1 (VDD), D55.1 (VDD), D58.1 (VDD), D63.1 (VDD), D66.1 (VDD), D71.1 (VDD), D75.1 (VDD), D76.1 (VDD), D79.1 (VDD), D84.1 (VDD), D87.1 (VDD), D92.1 (VDD), D96.1 (VDD), D97.1 (VDD), D100.1 (VDD), D105.1 (VDD), D108.1 (VDD), D109.1 (VDD), D113.1 (VDD), D121.1 (VDD), D129.1 (VDD), D134.1 (VDD), D142.1 (VDD); also elsewhere on the board
DATA_108: D109.4 (DIN); also elsewhere on the board
DATA_109: D96.4 (DIN), D109.2 (DOUT)
DATA_110: D75.4 (DIN), D96.2 (DOUT)
DATA_111: D54.4 (DIN), D75.2 (DOUT)
DATA_112: D41.4 (DIN), D54.2 (DOUT)
DATA_113: D28.4 (DIN), D41.2 (DOUT)
DATA_114: D15.4 (DIN), D28.2 (DOUT)
DATA_115: D7.4 (DIN), D15.2 (DOUT)
DATA_116: D2.4 (DIN), D7.2 (DOUT)
DATA_117: D2.2 (DOUT), D5.4 (DIN)
DATA_118: D5.2 (DOUT), D13.4 (DIN)
DATA_119: D13.2 (DOUT), D21.4 (DIN)
DATA_120: D21.2 (DOUT), D34.4 (DIN)
DATA_121: D34.2 (DOUT), D47.4 (DIN)
DATA_122: D47.2 (DOUT), D55.4 (DIN)
DATA_123: D55.2 (DOUT), D76.4 (DIN)
DATA_124: D76.2 (DOUT), D97.4 (DIN)
DATA_125: D42.4 (DIN), D97.2 (DOUT)
DATA_126: D42.2 (DOUT), D63.4 (DIN)
DATA_127: D63.2 (DOUT), D84.4 (DIN)
DATA_128: D84.2 (DOUT), D105.4 (DIN)
DATA_129: D71.4 (DIN), D105.2 (DOUT)
DATA_130: D71.2 (DOUT), D92.4 (DIN)
DATA_131: D92.2 (DOUT), D113.4 (DIN)
DATA_132: D113.2 (DOUT), D134.4 (DIN)
DATA_133: D100.4 (DIN), D134.2 (DOUT)
DATA_134: D79.4 (DIN), D100.2 (DOUT)
DATA_135: D58.4 (DIN), D79.2 (DOUT)
DATA_136: D45.4 (DIN), D58.2 (DOUT)
DATA_137: D32.4 (DIN), D45.2 (DOUT)
DATA_138: D32.2 (DOUT), D66.4 (DIN)
DATA_139: D66.2 (DOUT), D87.4 (DIN)
DATA_140: D87.2 (DOUT), D108.4 (DIN)
DATA_141: D108.2 (DOUT), D129.4 (DIN)
DATA_142: D129.2 (DOUT), D142.4 (DIN)
DATA_143: D121.4 (DIN), D142.2 (DOUT)
GND: D2.3 (VSS), D5.3 (VSS), D7.3 (VSS), D13.3 (VSS), D15.3 (VSS), D21.3 (VSS), D28.3 (VSS), D32.3 (VSS), D34.3 (VSS), D41.3 (VSS), D42.3 (VSS), D45.3 (VSS), D47.3 (VSS), D54.3 (VSS), D55.3 (VSS), D58.3 (VSS), D63.3 (VSS), D66.3 (VSS), D71.3 (VSS), D75.3 (VSS), D76.3 (VSS), D79.3 (VSS), D84.3 (VSS), D87.3 (VSS), D92.3 (VSS), D96.3 (VSS), D97.3 (VSS), D100.3 (VSS), D105.3 (VSS), D108.3 (VSS), D109.3 (VSS), D113.3 (VSS), D121.3 (VSS), D129.3 (VSS), D134.3 (VSS), D142.3 (VSS); also elsewhere on the board

Notes on the sheet:
PHYLLO / LED chain 109-144 / candidate pin-table schematic
Pin numbers/names from saved vendor library. Global labels join all sheets. No fabrication release.

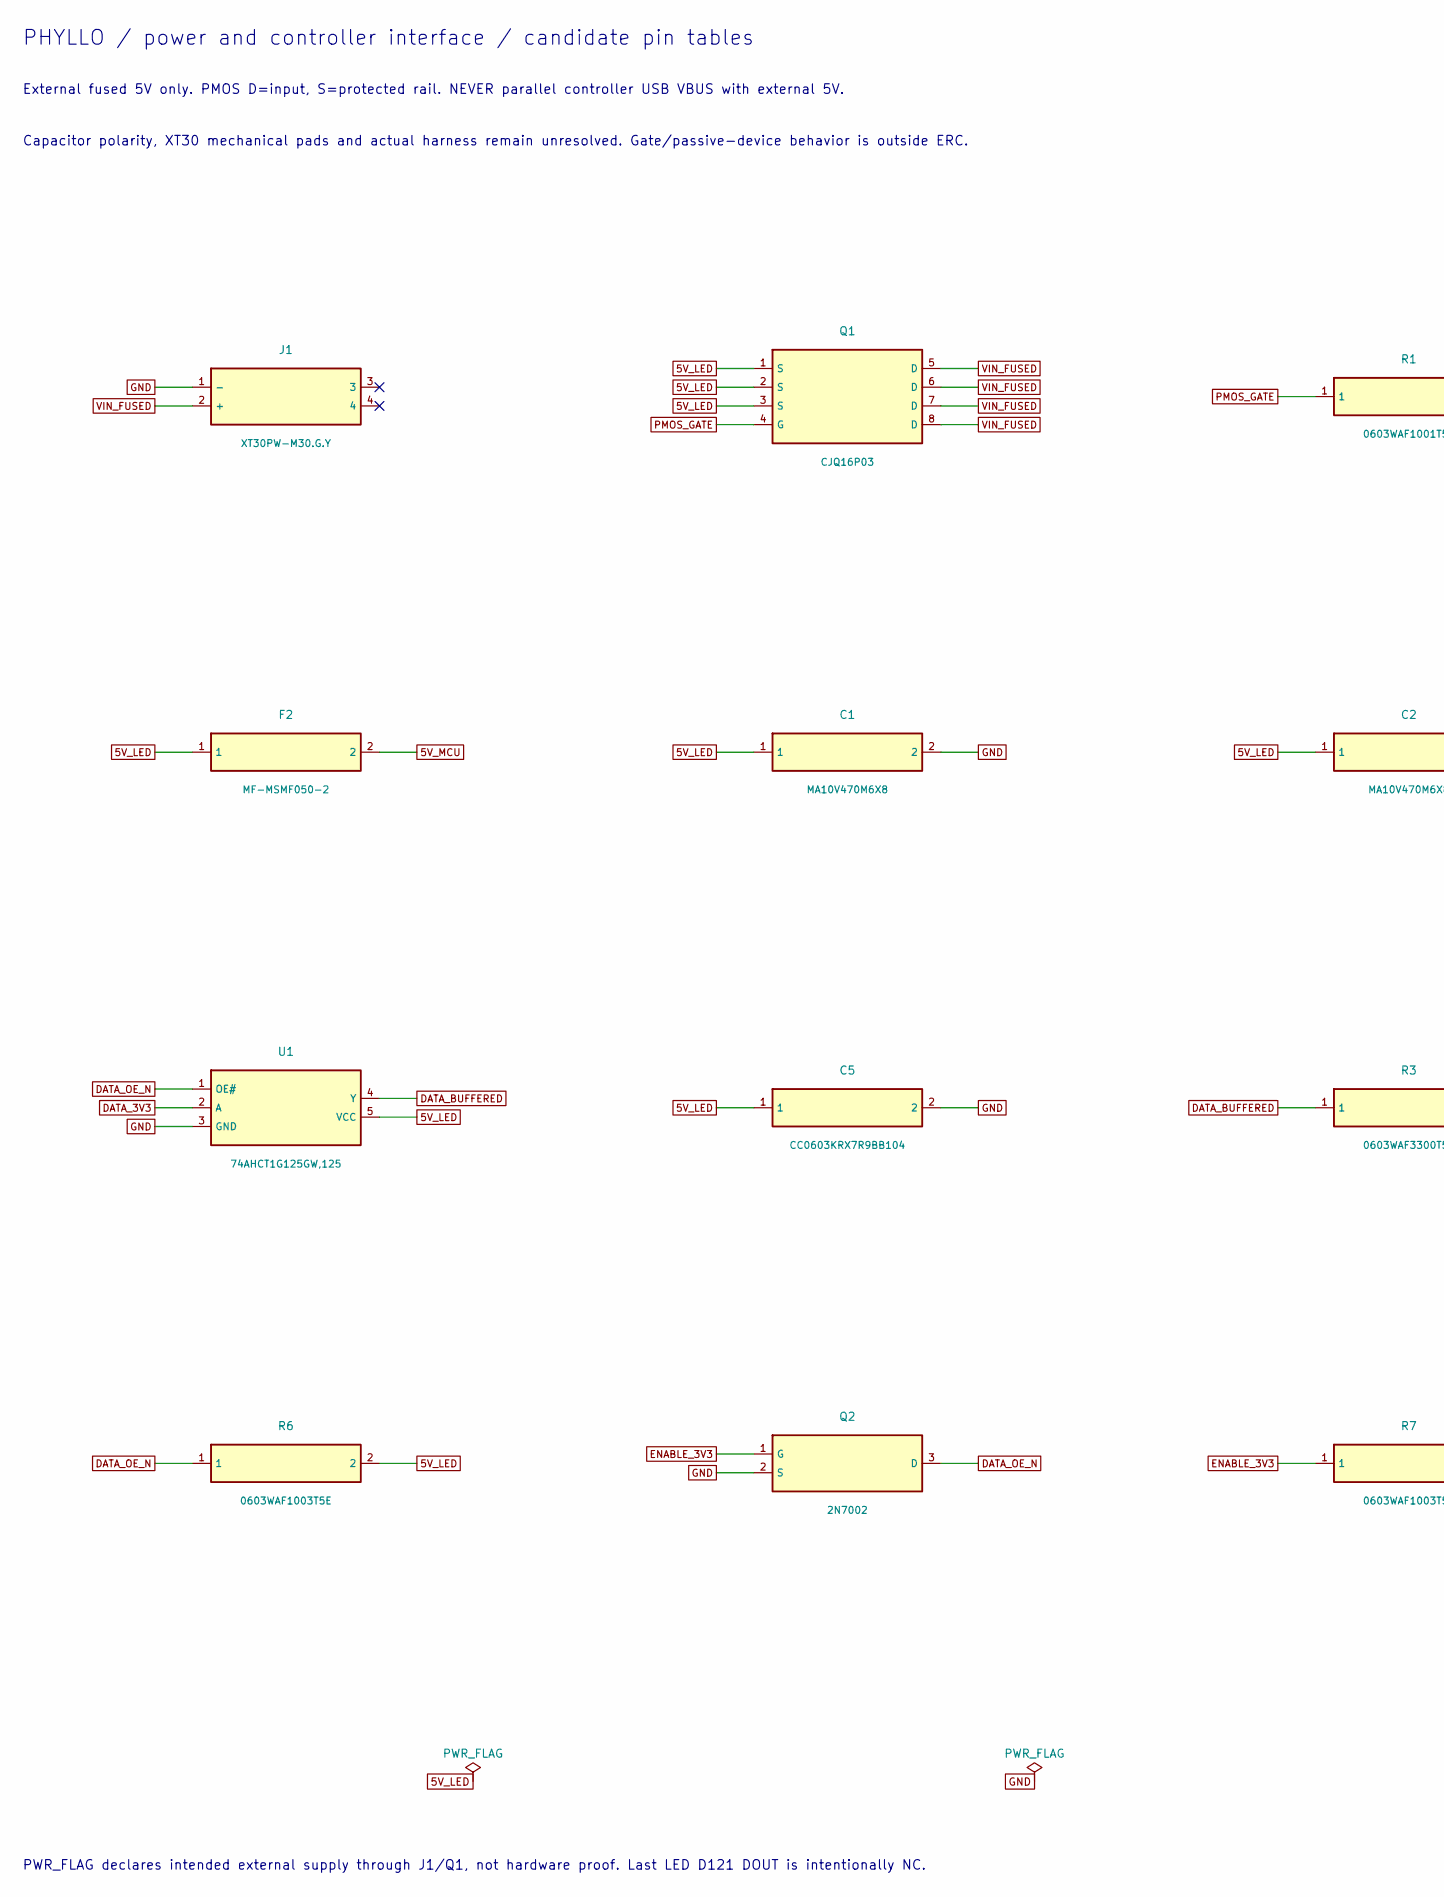
[picture p36: schematic power-interface.kicad_sch, Power and controller interface, part in row 1, column 1]

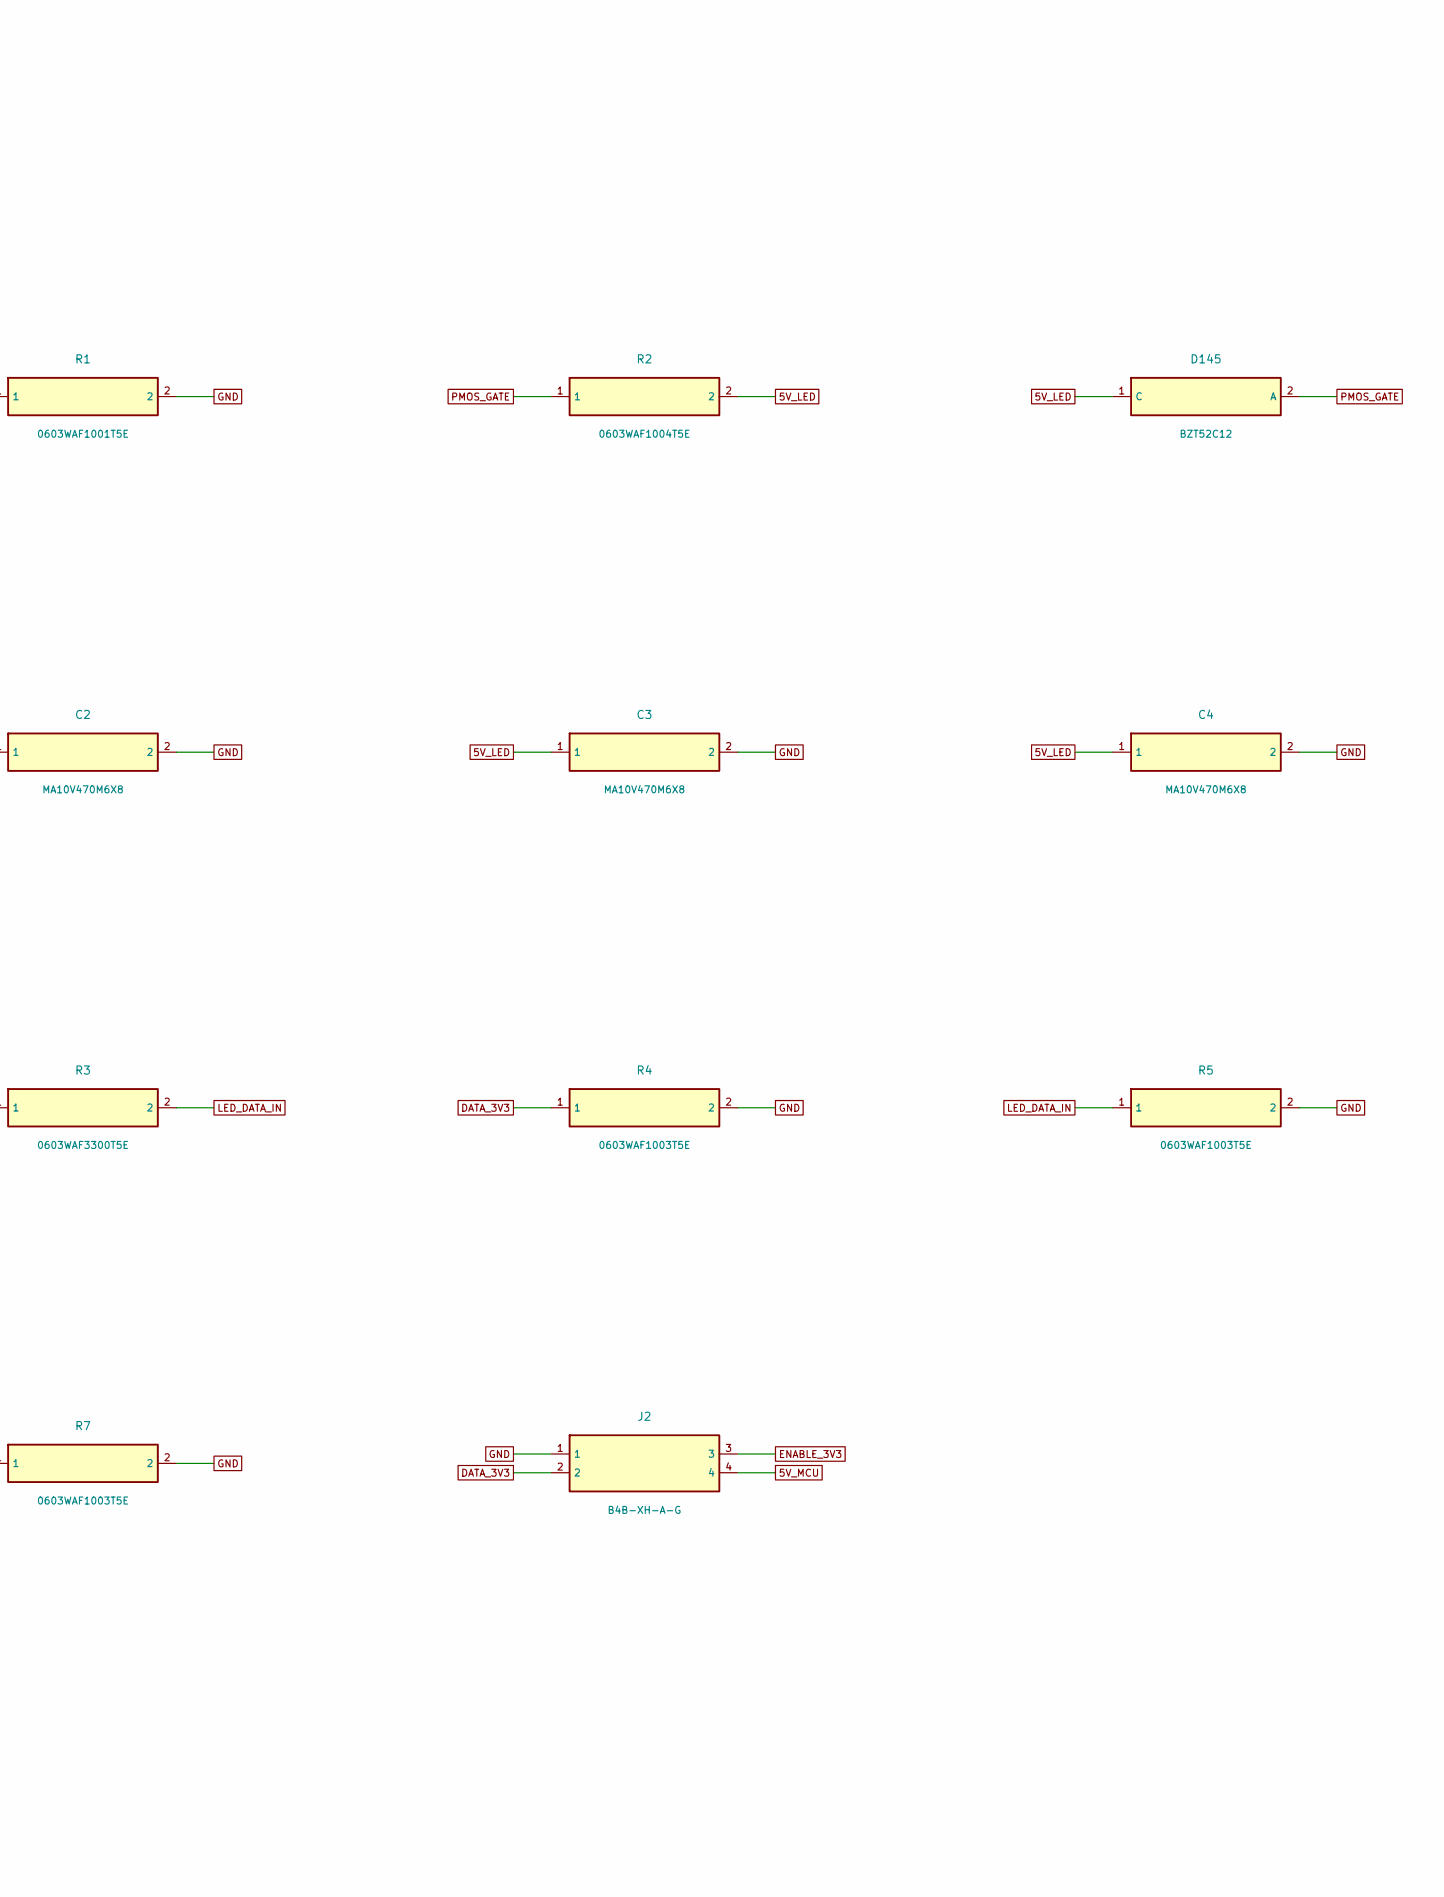
[picture p37: schematic power-interface.kicad_sch, Power and controller interface, part in row 1, column 2]

Parts:
C1, C2, C3, C4: MA10V470M6X8; C46550459
C5: CC0603KRX7R9BB104; C14663
D145: BZT52C12; C271259
F2: MF-MSMF050-2; C17313
J1: XT30PW-M30.G.Y; C431092
J2: B4B-XH-A-G; C594232
Q1: CJQ16P03; C2910138
Q2: 2N7002; C8545
R1: 0603WAF1001T5E; C21190
R2: 0603WAF1004T5E; C22935
R3: 0603WAF3300T5E; C23138
R4, R5, R6, R7: 0603WAF1003T5E; C25803
U1: 74AHCT1G125GW,125; C12495

Connections:
5V_LED: C1.1, C2.1, C3.1, C4.1, C5.1, D145.1 (C), F2.1, Q1.1 (S), Q1.2 (S), Q1.3 (S), R2.2, R6.2, U1.5 (VCC); also elsewhere on the board
5V_MCU: F2.2, J2.4
DATA_3V3: J2.2, R4.1, U1.2 (A)
DATA_BUFFERED: R3.1, U1.4 (Y)
DATA_OE_N: Q2.3 (D), R6.1, U1.1 (OE#)
ENABLE_3V3: J2.3, Q2.1 (G), R7.1
GND: C1.2, C2.2, C3.2, C4.2, C5.2, J1.1 (-), J2.1, Q2.2 (S), R1.2, R4.2, R5.2, R7.2, U1.3 (GND); also elsewhere on the board
LED_DATA_IN: R3.2, R5.1; also elsewhere on the board
PMOS_GATE: D145.2 (A), Q1.4 (G), R1.1, R2.1
VIN_FUSED: J1.2 (+), Q1.5 (D), Q1.6 (D), Q1.7 (D), Q1.8 (D)

Notes on the sheet:
PHYLLO / power and controller interface / candidate pin tables
External fused 5V only. PMOS D=input, S=protected rail. NEVER parallel controller USB VBUS with external 5V.
Capacitor polarity, XT30 mechanical pads and actual harness remain unresolved. Gate/passive-device behavior is outside ERC.
PWR_FLAG declares intended external supply through J1/Q1, not hardware proof. Last LED D121 DOUT is intentionally NC.

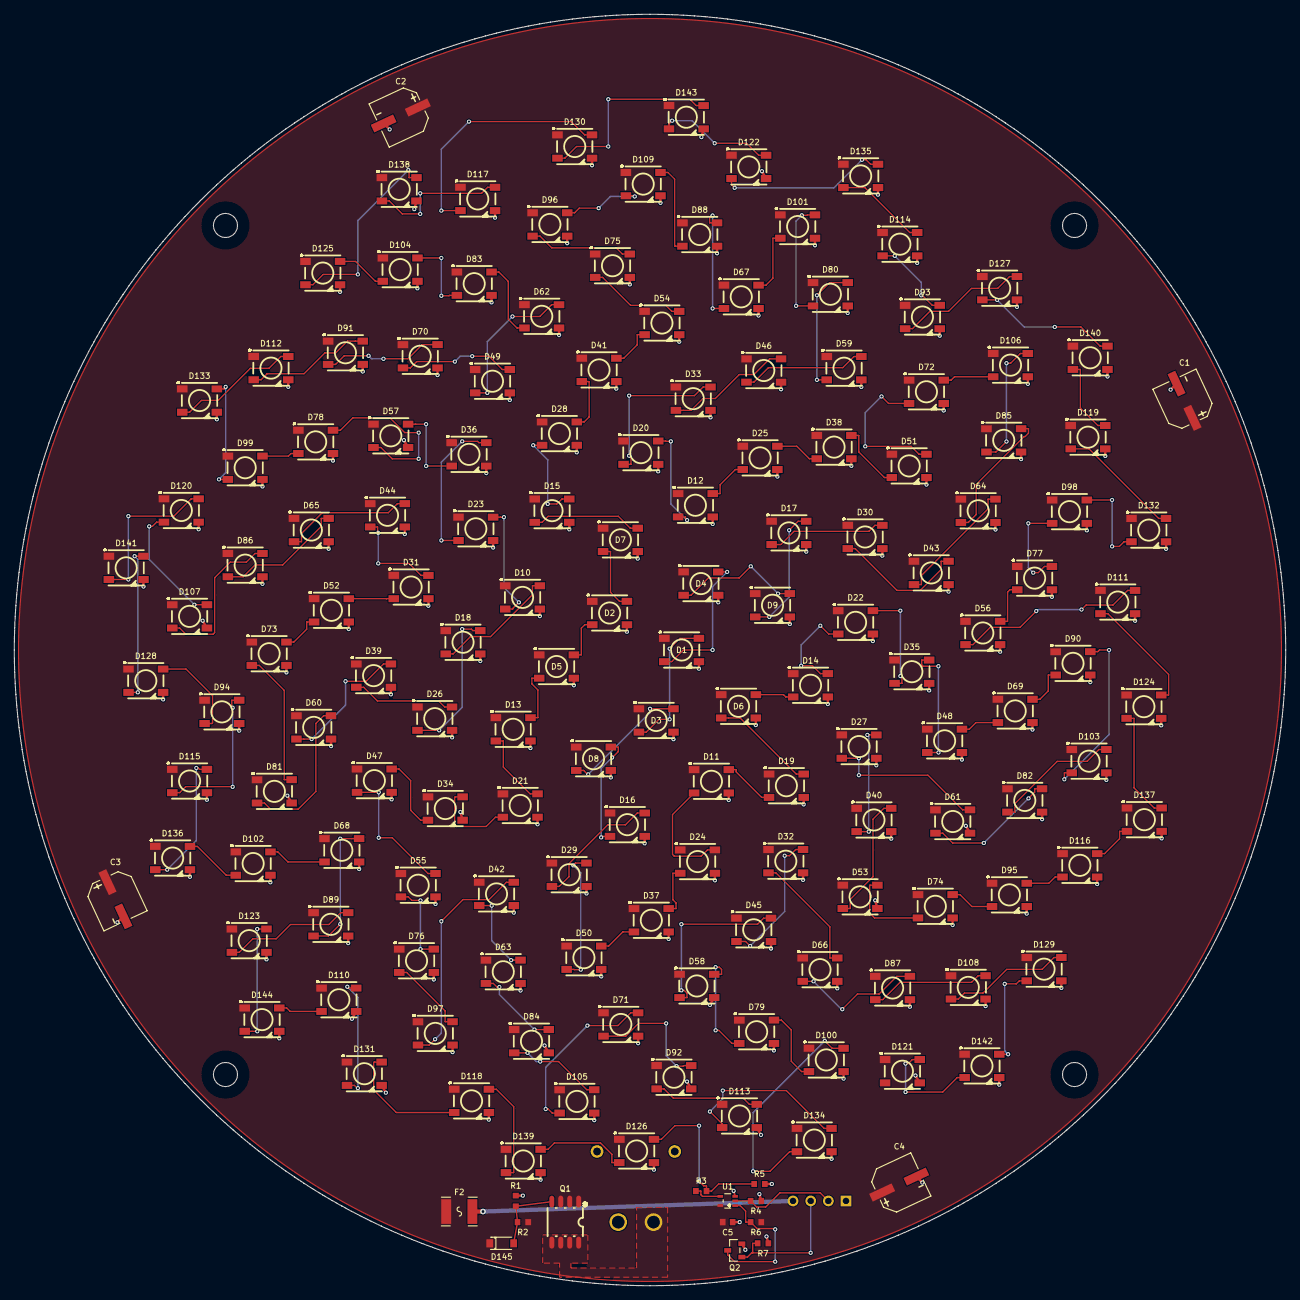
[picture p38: board phyllo-copper-review.kicad_pcb from above]

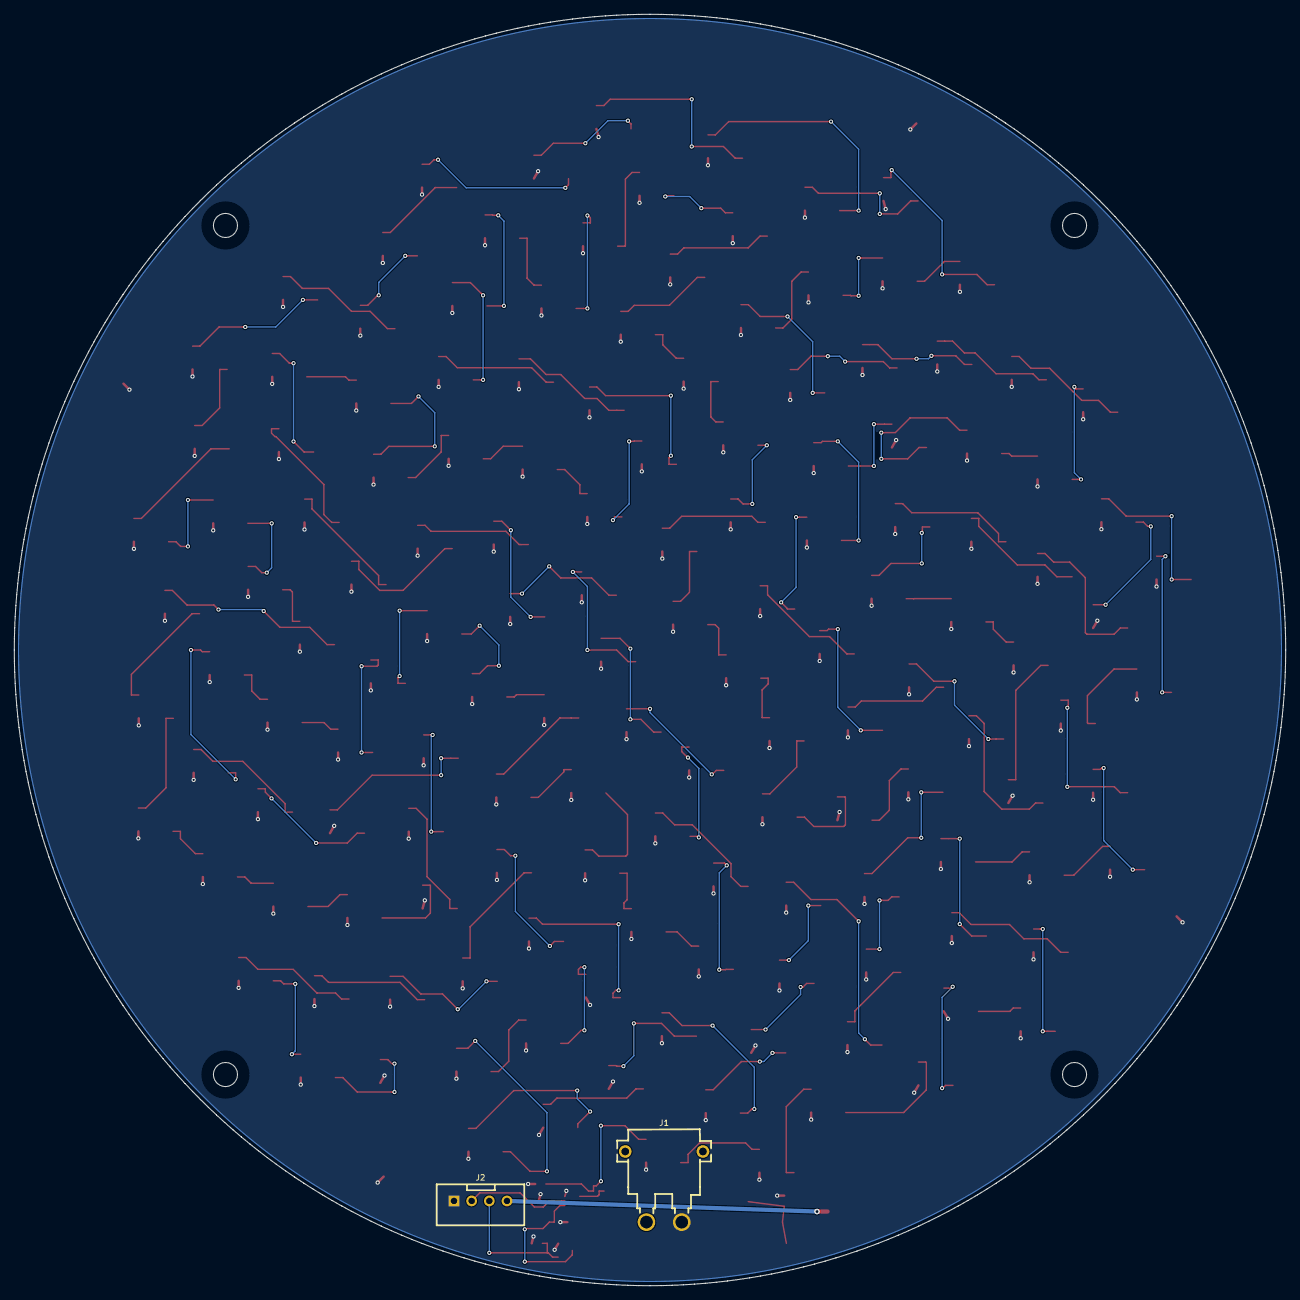
[picture p39: board phyllo-copper-review.kicad_pcb from below]

Board: 2 copper layers, 180.0 x 180.0 mm, 167 parts (2 on the bottom side), 153 nets.

Other parts of the board:
mount-1, mount-2, mount-3, mount-4: NPTH_3.4mm
